ssood123/Project-Emphy/README_HARDWARE.md

# Emphy Overview
The hardware for Emphy consists of three different components:
1. The OpenBot car
2. Raspberry pi
3. Leash. 

## OpenBot Car
The hardware design for our final prototype was taken directly from the [OpenBot GitHub](https://github.com/intel-isl/OpenBot/tree/master). This design includes 4 different 3D printed parts for the chassis as shown below. The cad designs and STL files for 3D printing can be found on the OpenBot Github under [body](https://github.com/intel-isl/OpenBot/tree/master/body). While we stuck with the basic design, it can be edited to include space to place a raspberry pi and its power source within the insides of the chassis as well as a mounting point for the leash. 
The design for OpenBot is shown below. It consists on 3D printed parts and off the shelf hardware and electronics which can all be bought online. The complete list of parts required for this car can be found [here](https://github.com/intel-isl/OpenBot/tree/master/body). 

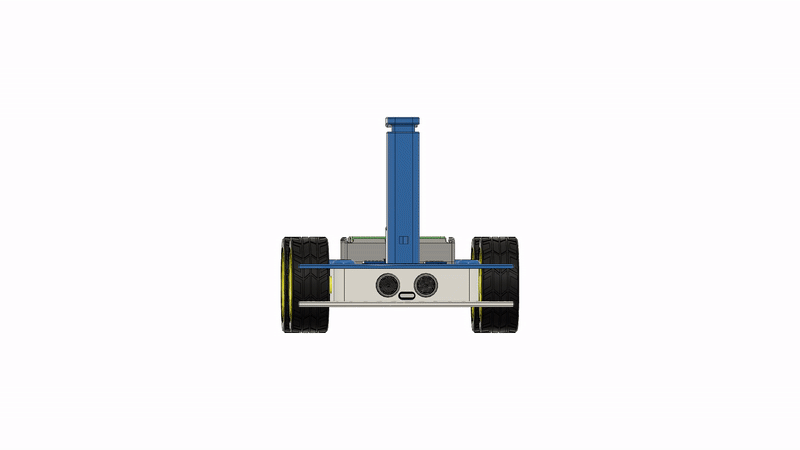
[picture p1: Images/assembly.gif]
Assembly


The wiring and components images for the car below are taken from the OpenBot github.

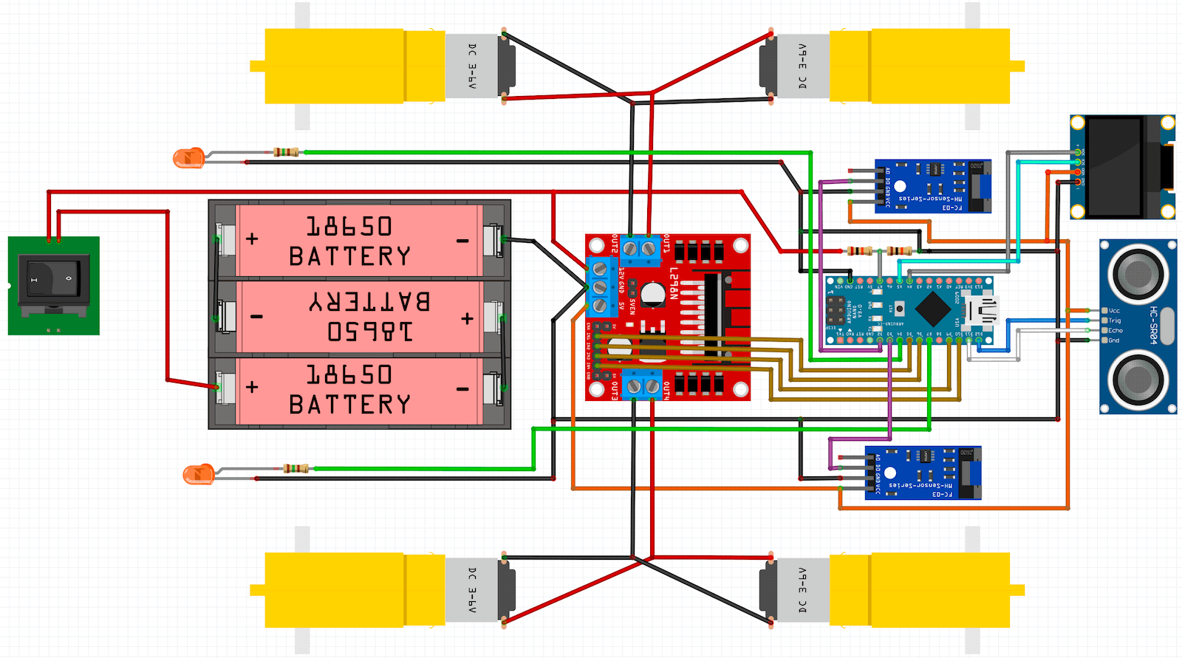
[picture p2: Images/wiring_diagram.png]

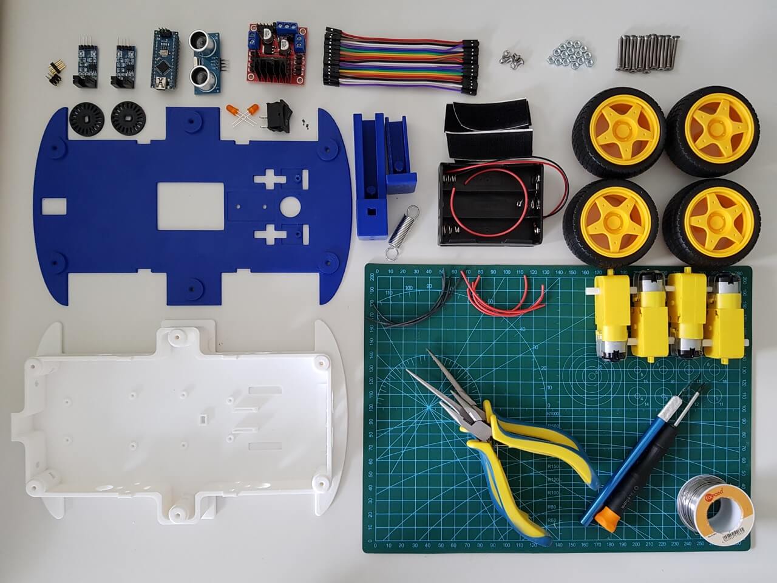
[picture p3: Images/diy_parts.jpg]

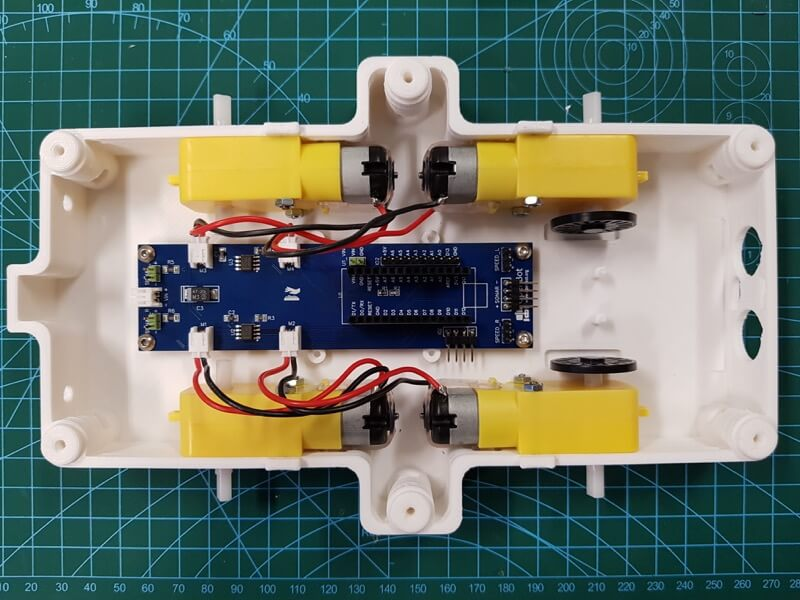
[picture p4: Images/chassis_motors_pcb.jpg]


When assembling this robot ourselves using an arduino nano and not a custom pcb, the complexity of the internal wiring and the assembeled OpenBot is shown below. This still requires the leash and Raspberry pi to be added which are discussed later.

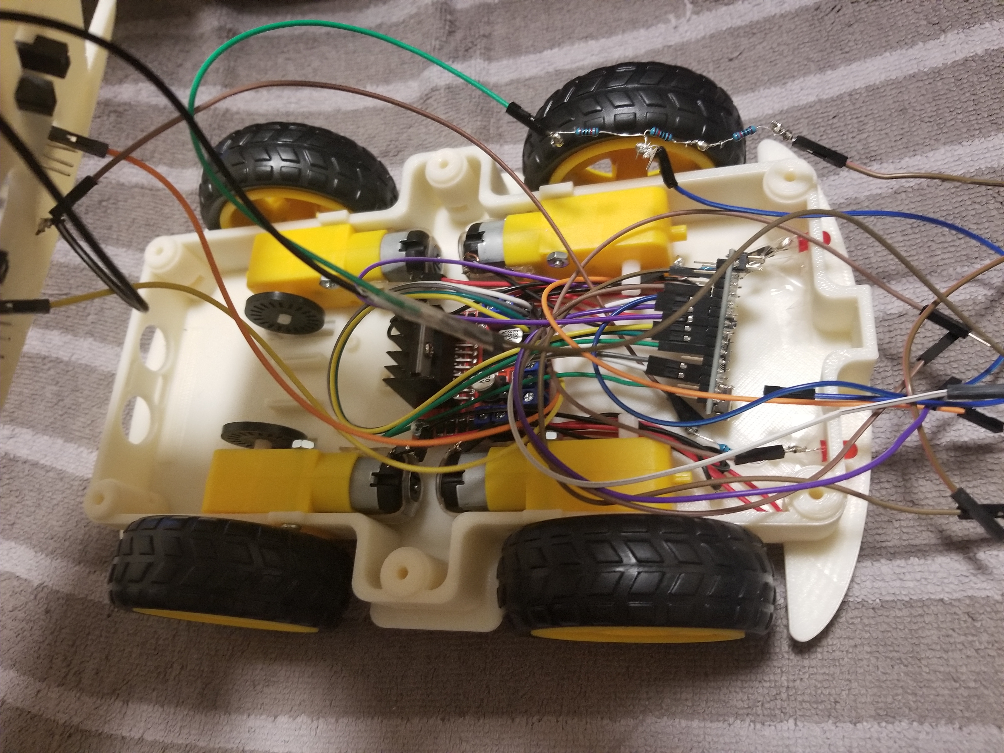
[picture p5: Images/internal_wiring.jpg]

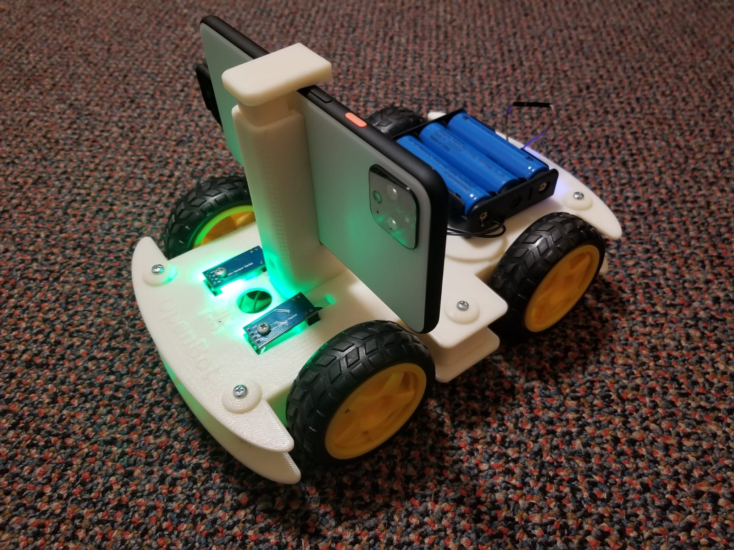
[picture p6: Images/OpenBot.jpeg]



## Raspberry Pi 4B
To control the OpenBot robot, we use a raspberry pi 4B which can communicate with the OpenBot application. There are no special instructions needed for the raspberry pi setup and previous version of raspberry pi with Wifi capabilites should be capable of running the [Emphy.py](https://github.com/BostonUniversitySeniorDesign/21-07-Emphy/blob/main/Emphy-OpenBot/Emphy.py) python script on them. The leash is connected to the raspberry pi through hardware pins and a USB headset which acts as a speaker and mic is connected to the Raspberry pi. The assembly of the leash is described below while the Headset can be any regular [headset](https://www.bestbuy.com/site/insignia-on-ear-analog-mono-headset-black/5648055.p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). The headset needs to be correctly set up which is described in the software readme file and in the future, can possibly be replaced with a bluetooth headset. The raspberry pi is attached to the car body as shown below. Changes to the 3D printed body can allow for the Pi and the battery pack to be stored within the body.

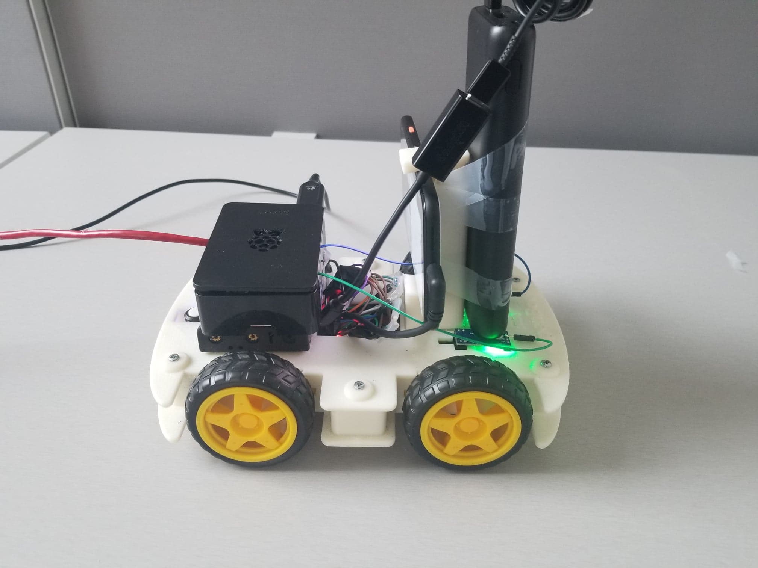
[picture p7: Images/latest1.jpg]

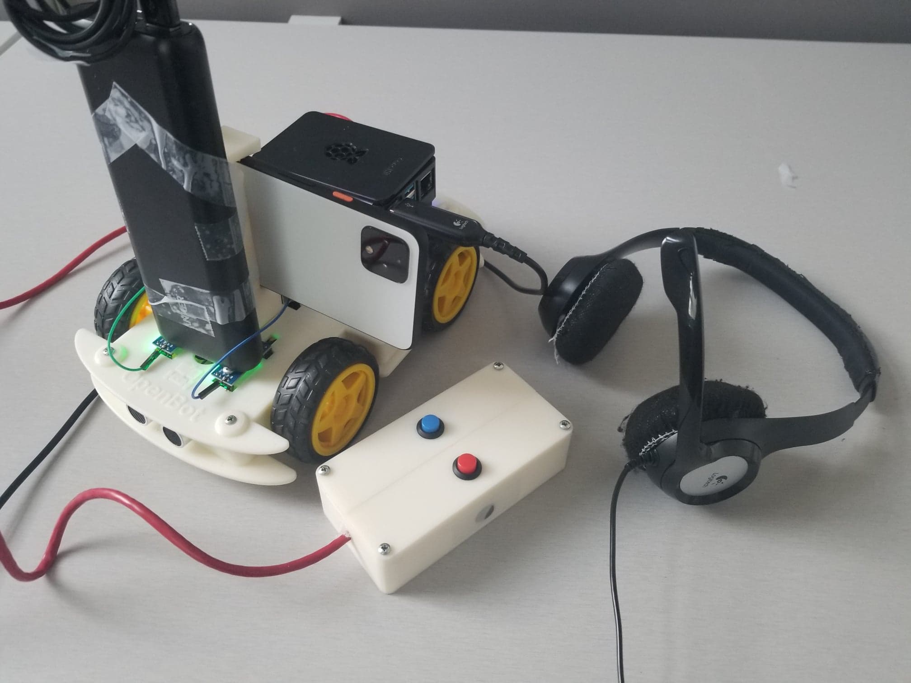
[picture p8: Images/latest2.jpg]

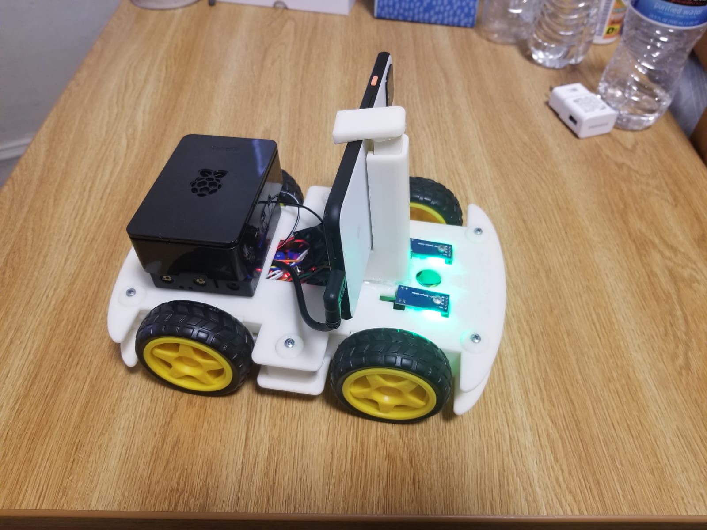
[picture p9: Images/OpenBot3.jpeg]

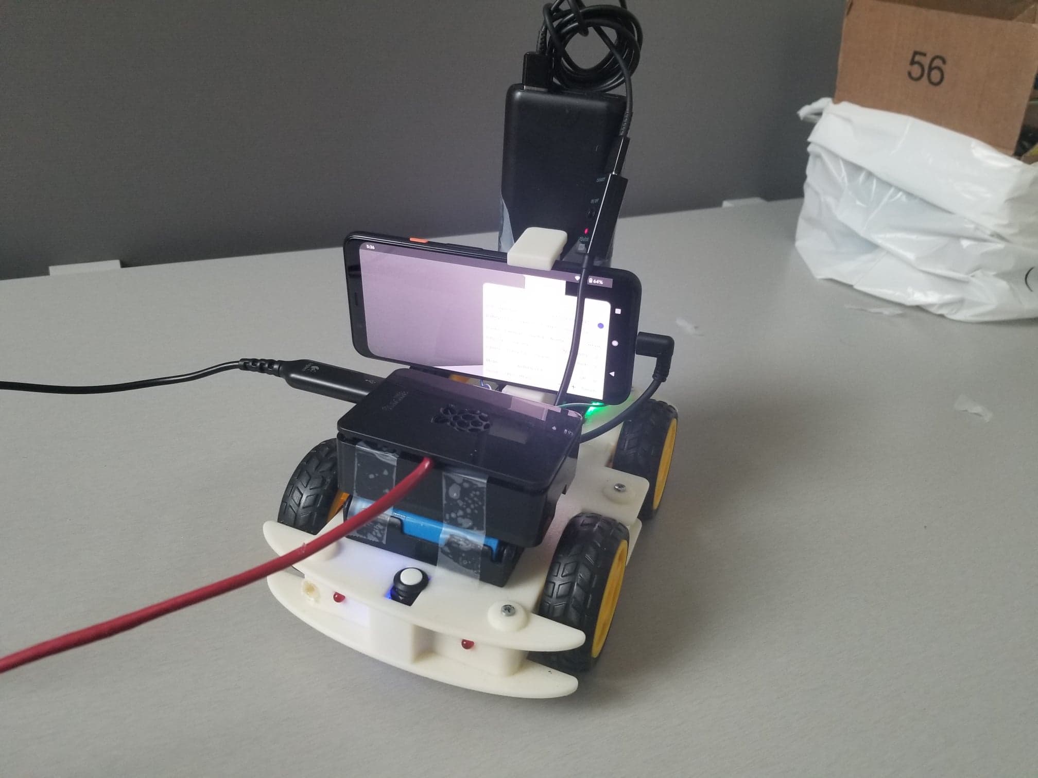
[picture p10: Images/latest4.jpg]


### Leash Box
The purpose of the leash is to establish a way for the user to communicate with Emphy as well as a way for the car to communicate back to the user, through haptic feedback implemented on the leash as well as audio output through the Headset. The leash consists of two vibration motors on the left and right of the leash to indicate where the car will turn. There are also two buttons on the top of the leash, one to pause the robot in its track and the other to stop the robot from continuing on the current path and to ask the user again for a new destination. These components are then connected to the raspberry pi over a long wire which also acts as a leash for the user to hold. The 3D printed box acts as a handle for the user.
The CAD files inside LeashBox folder is for the box attached to the leash. They are in stl format and can be used to 3D printed the box. The box’s dimension is 12x6x3 cm. The lid has two identical parts. On the lid there are two holes for the buttons and four holes on the corner which are placed for the screws to connect the lid and the box body. The box has two holes on the sides for vibration motor and a hole on the front for the wire to go through.
The CAD is done using onShape.

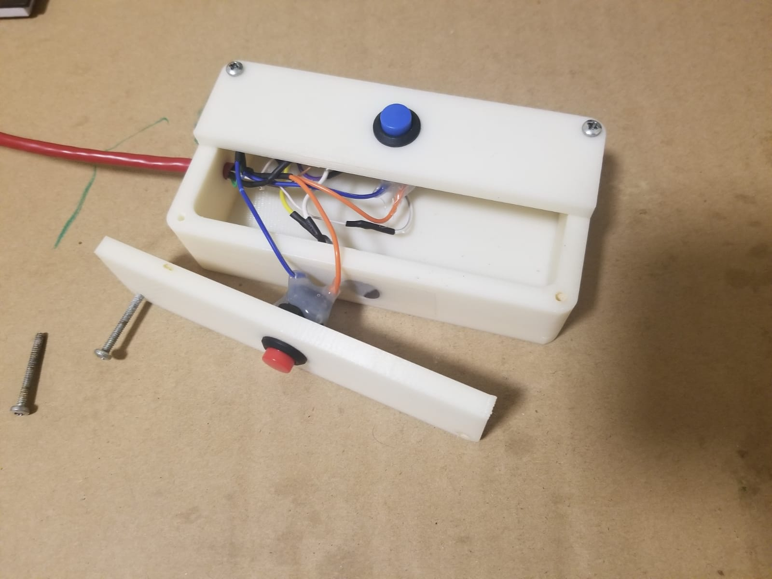
[picture p11: Images/leash.jpeg]

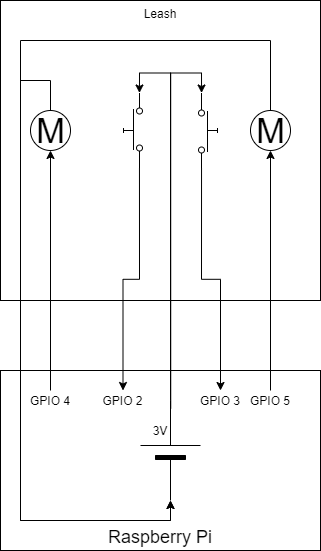
[picture p12: Images/Leash_diagram.png]
