ssood123/Project-Emphy/Emphy-OpenBot/OpenBot-master/docs/images/add_disk_motor.jpg

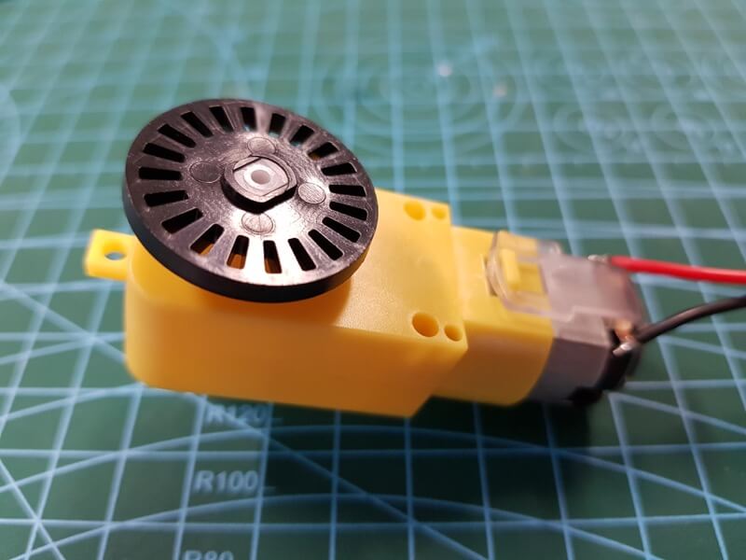
Emphy-OpenBot/OpenBot-master/docs/images/add_disk_motor.jpg
