ssood123/Project-Emphy/Emphy-OpenBot/OpenBot-master/docs/images/add_wires_motor.jpg

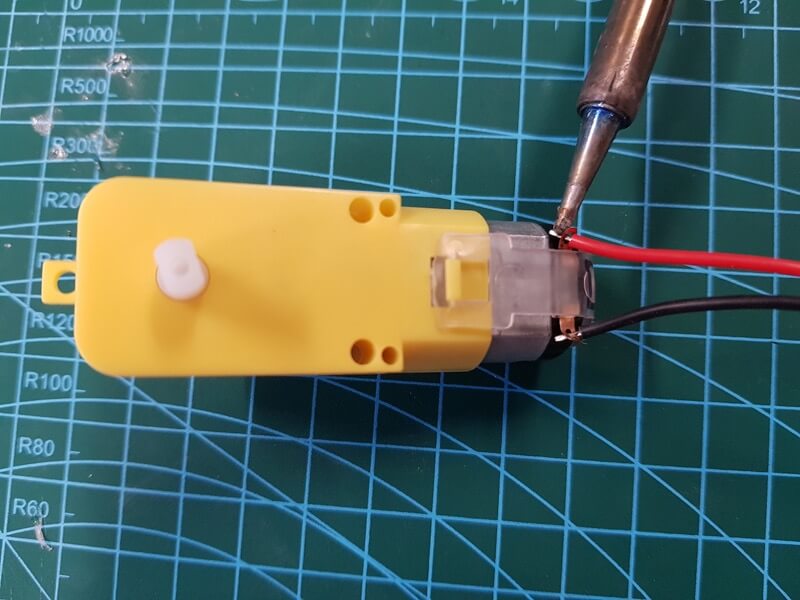
Emphy-OpenBot/OpenBot-master/docs/images/add_wires_motor.jpg
