ssood123/Project-Emphy/Emphy-OpenBot/OpenBot-master/docs/images/ai_screen.jpg

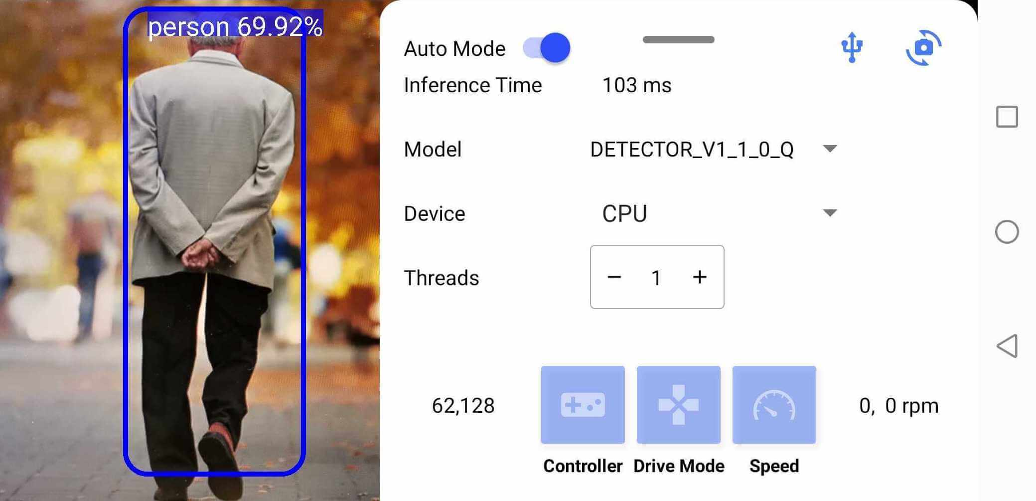
Emphy-OpenBot/OpenBot-master/docs/images/ai_screen.jpg
