ssood123/Project-Emphy/Emphy-OpenBot/OpenBot-master/docs/images/android_studio_sdk.jpg

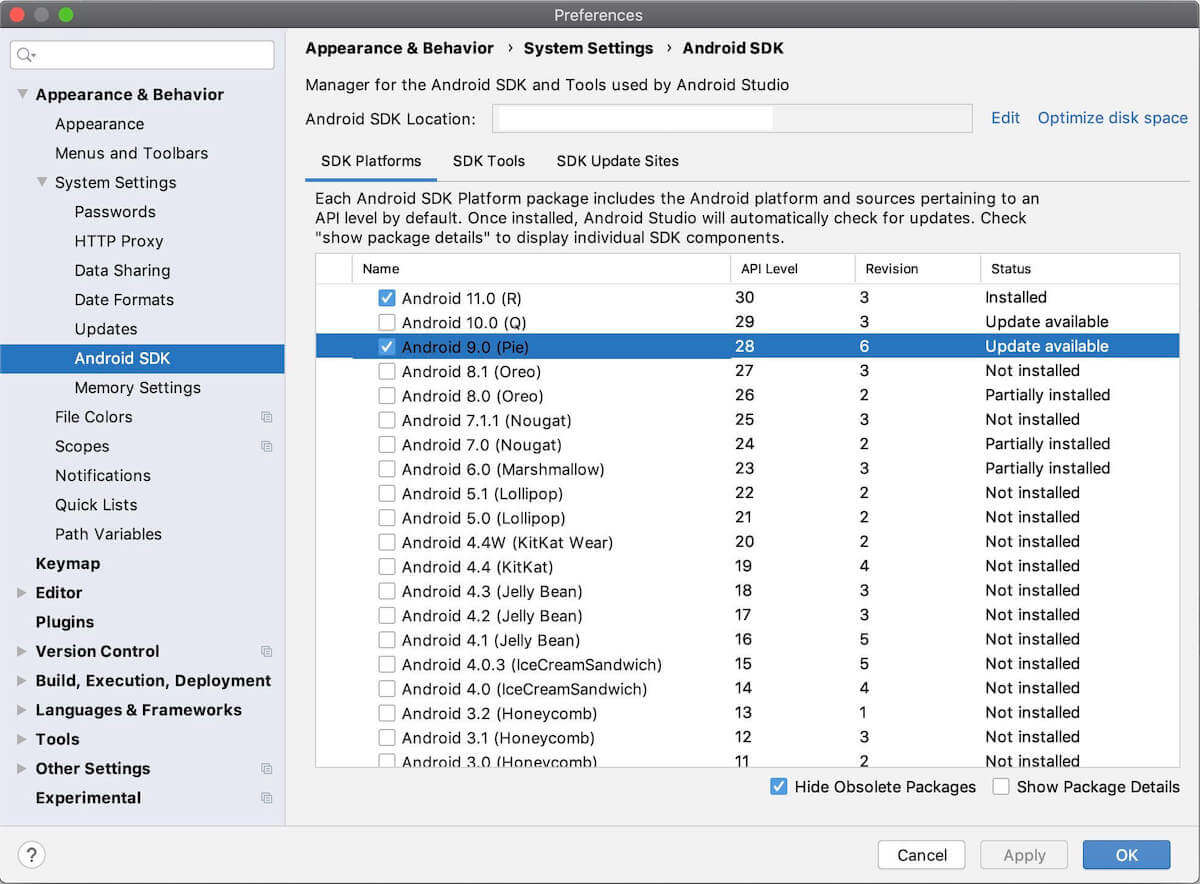
Emphy-OpenBot/OpenBot-master/docs/images/android_studio_sdk.jpg
