ssood123/Project-Emphy/Emphy-OpenBot/OpenBot-master/docs/images/android_studio_tflite_dir.jpg

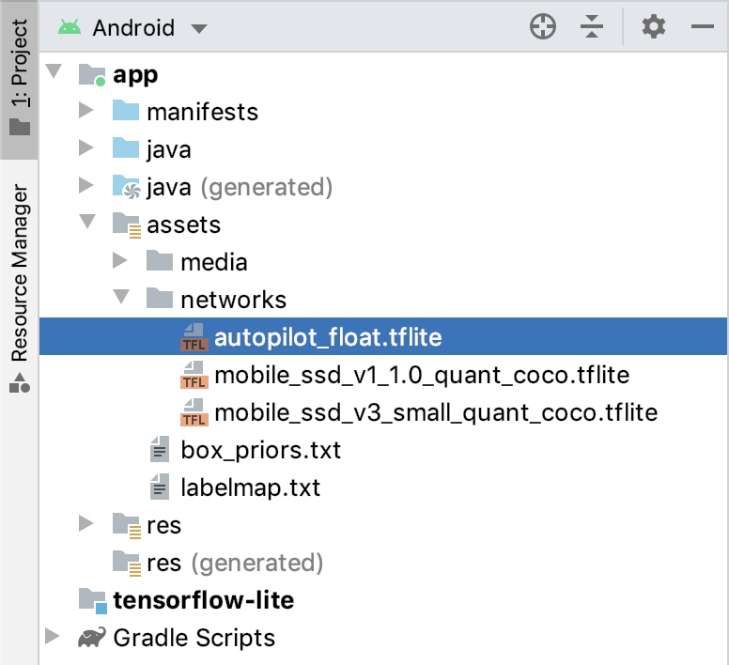
Emphy-OpenBot/OpenBot-master/docs/images/android_studio_tflite_dir.jpg
