ssood123/Project-Emphy/Emphy-OpenBot/OpenBot-master/docs/images/app_controller_settings_1.png

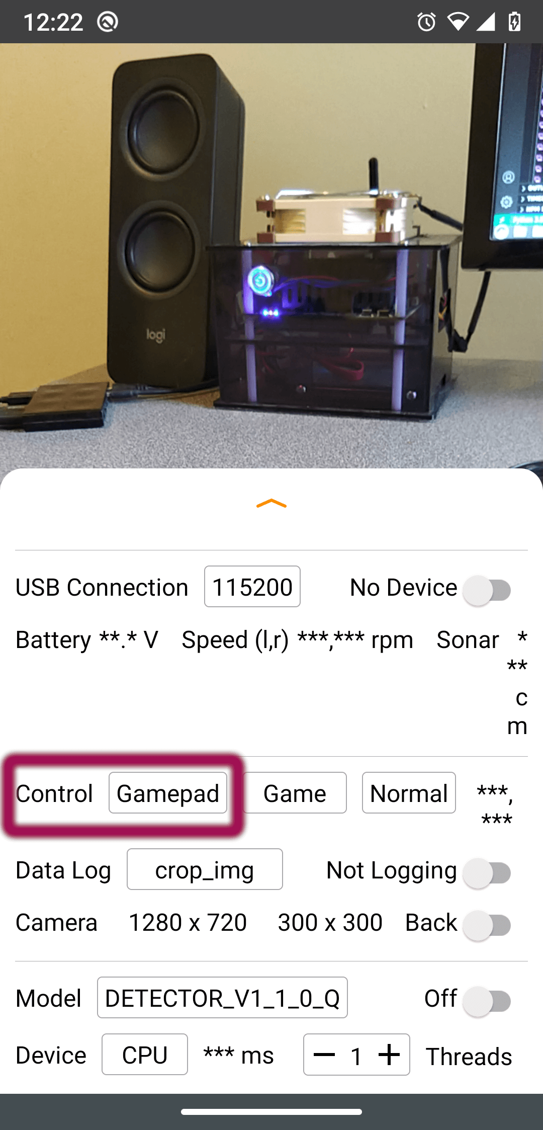
Emphy-OpenBot/OpenBot-master/docs/images/app_controller_settings_1.png
