ssood123/Project-Emphy/Emphy-OpenBot/OpenBot-master/docs/images/app_gui_1.jpg

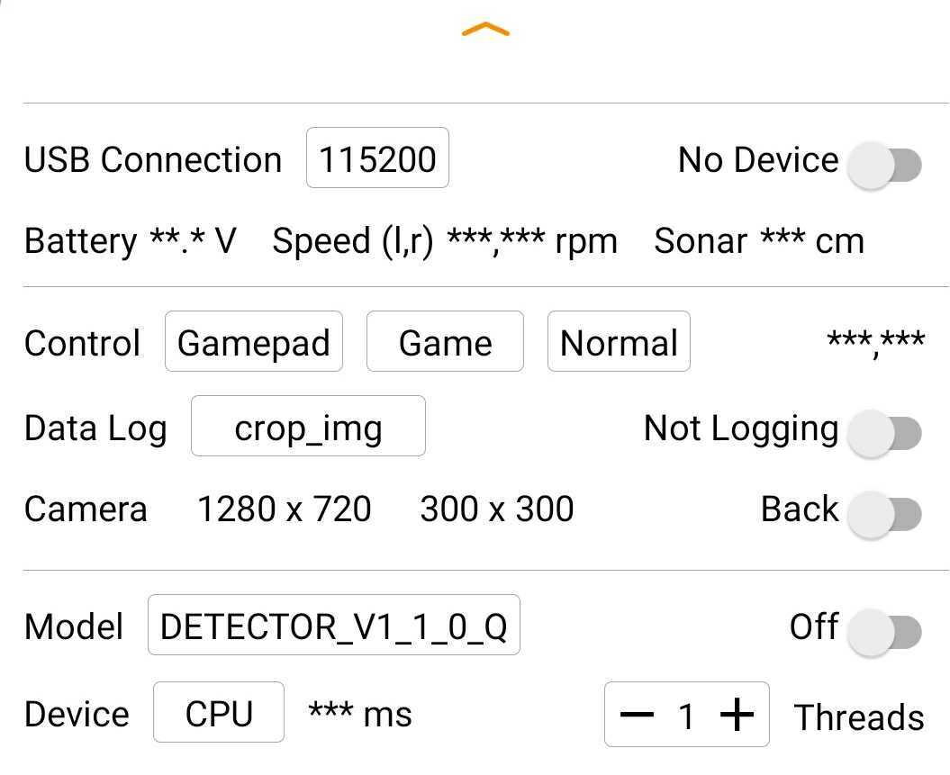
Emphy-OpenBot/OpenBot-master/docs/images/app_gui_1.jpg
