ssood123/Project-Emphy/Emphy-OpenBot/OpenBot-master/docs/images/app_gui_2.jpg

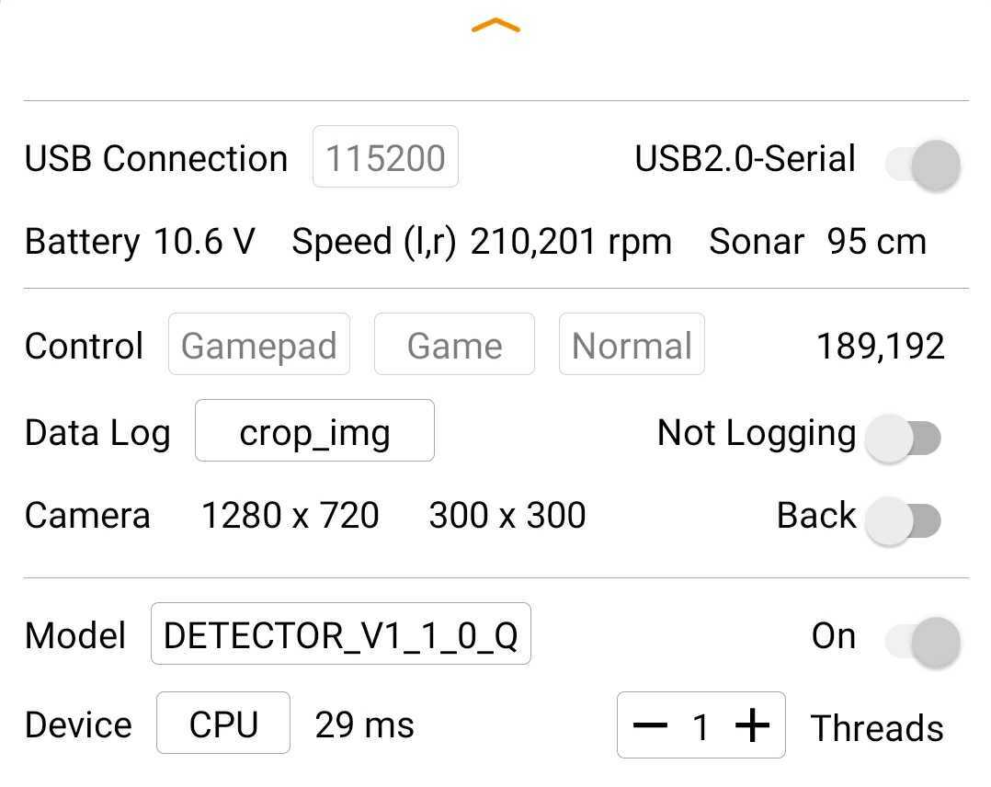
Emphy-OpenBot/OpenBot-master/docs/images/app_gui_2.jpg
