ssood123/Project-Emphy/Emphy-OpenBot/OpenBot-master/docs/images/app_teaser.jpg

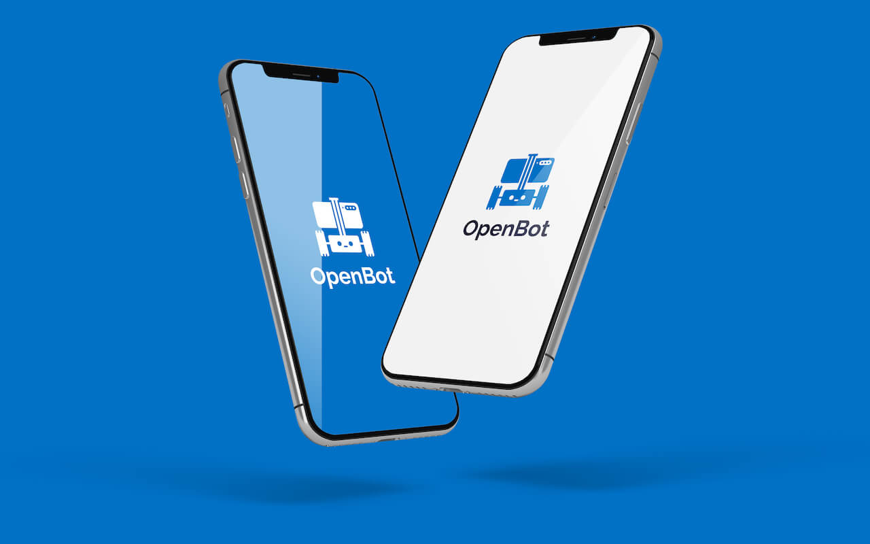
Emphy-OpenBot/OpenBot-master/docs/images/app_teaser.jpg
