ssood123/Project-Emphy/Emphy-OpenBot/OpenBot-master/docs/images/attach_motors_2.jpg

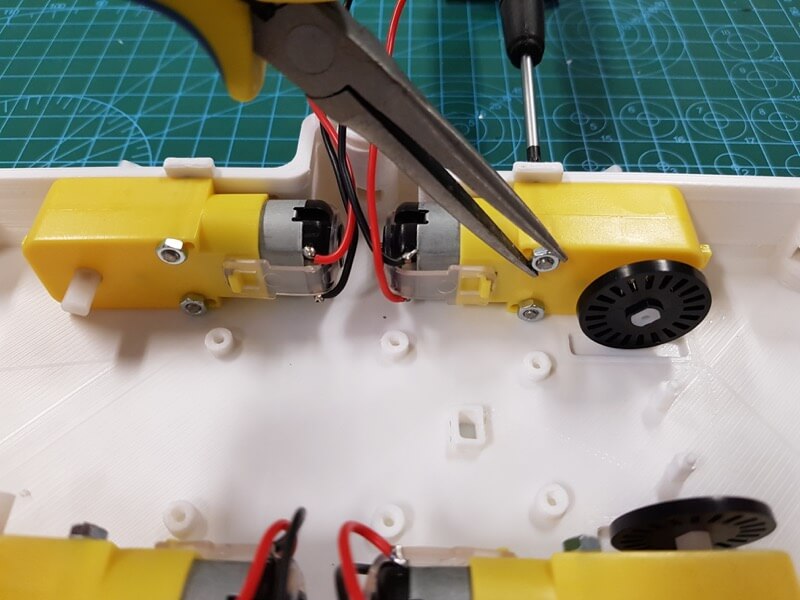
Emphy-OpenBot/OpenBot-master/docs/images/attach_motors_2.jpg
