ssood123/Project-Emphy/Emphy-OpenBot/OpenBot-master/docs/images/attach_motors_3.jpg

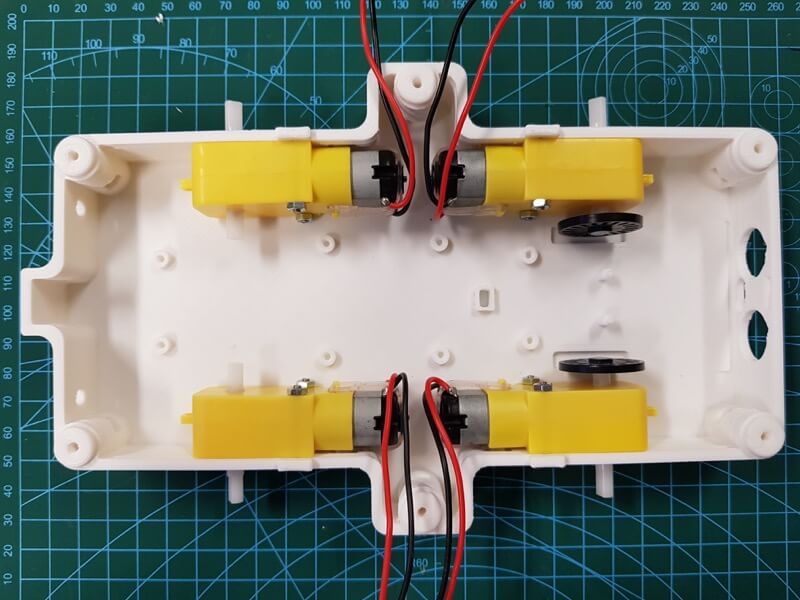
Emphy-OpenBot/OpenBot-master/docs/images/attach_motors_3.jpg
