ssood123/Project-Emphy/Emphy-OpenBot/OpenBot-master/docs/images/attach_pcb.jpg

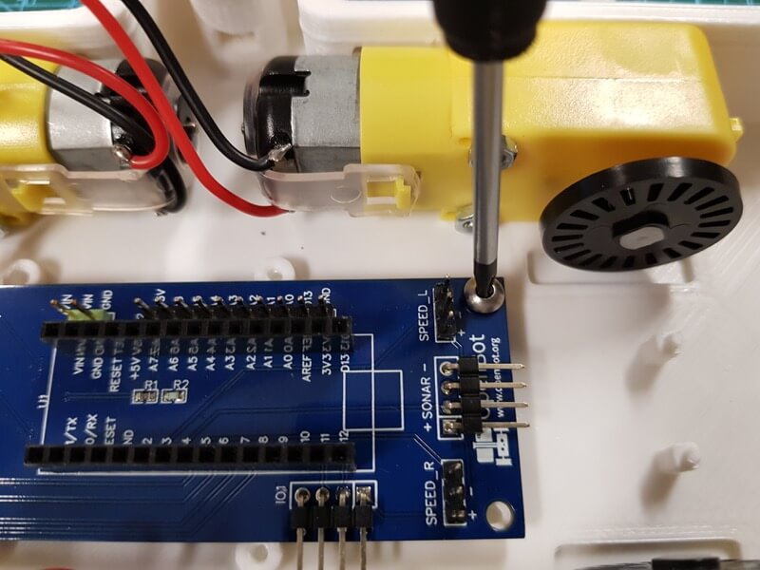
Emphy-OpenBot/OpenBot-master/docs/images/attach_pcb.jpg
