ssood123/Project-Emphy/Emphy-OpenBot/OpenBot-master/docs/images/chassis_cardboard_1.jpg

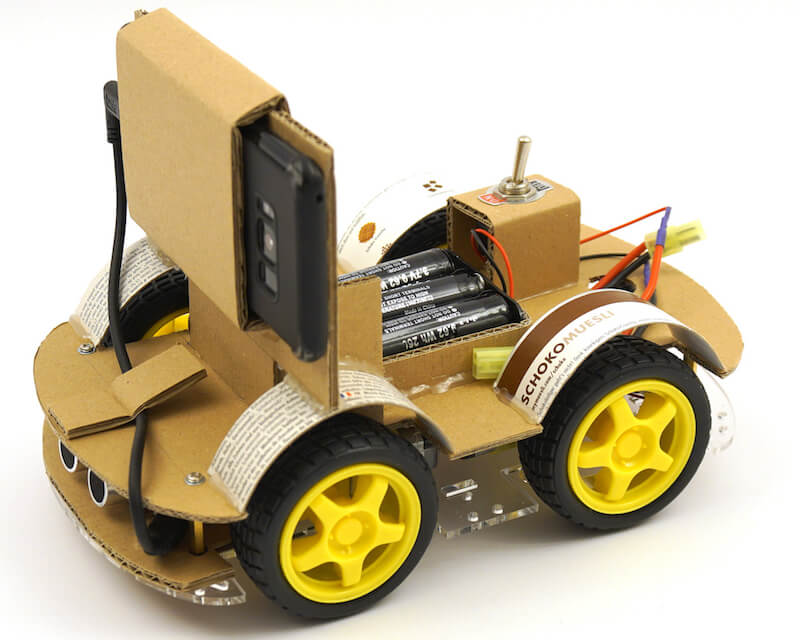
Emphy-OpenBot/OpenBot-master/docs/images/chassis_cardboard_1.jpg
