ssood123/Project-Emphy/Emphy-OpenBot/OpenBot-master/docs/images/chassis_cardboard_2.jpg

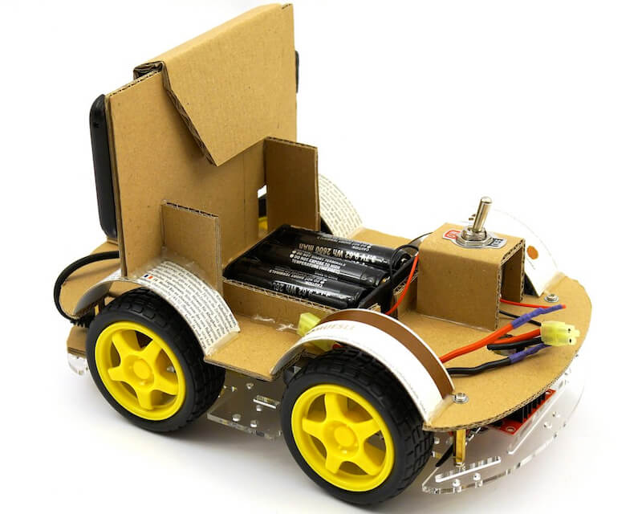
Emphy-OpenBot/OpenBot-master/docs/images/chassis_cardboard_2.jpg
