ssood123/Project-Emphy/Emphy-OpenBot/OpenBot-master/docs/images/connect_motors_pcb.jpg

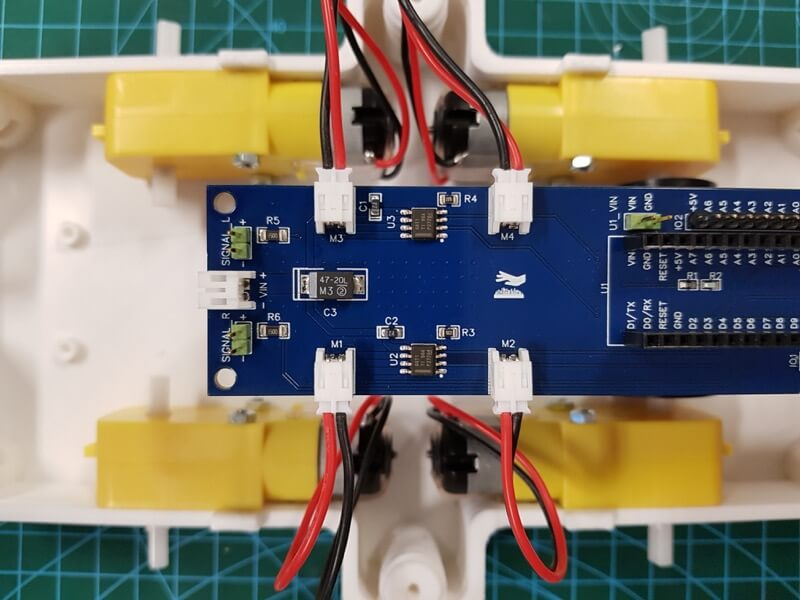
Emphy-OpenBot/OpenBot-master/docs/images/connect_motors_pcb.jpg
