ssood123/Project-Emphy/Emphy-OpenBot/OpenBot-master/docs/images/connect_sonar_sensor.jpg

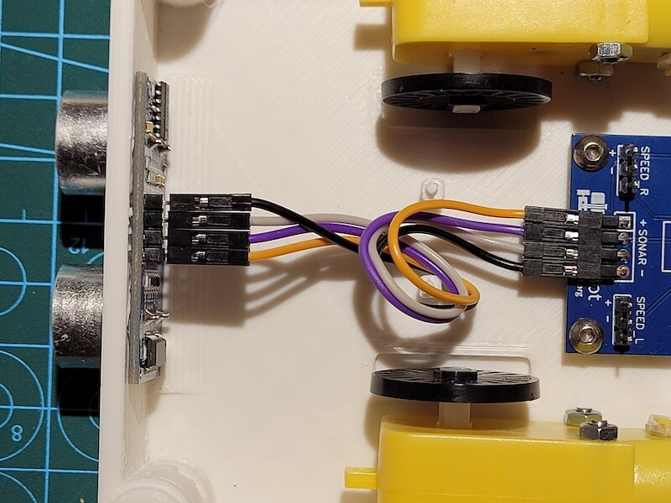
Emphy-OpenBot/OpenBot-master/docs/images/connect_sonar_sensor.jpg
