ssood123/Project-Emphy/Emphy-OpenBot/OpenBot-master/docs/images/controller_command_buttons.png

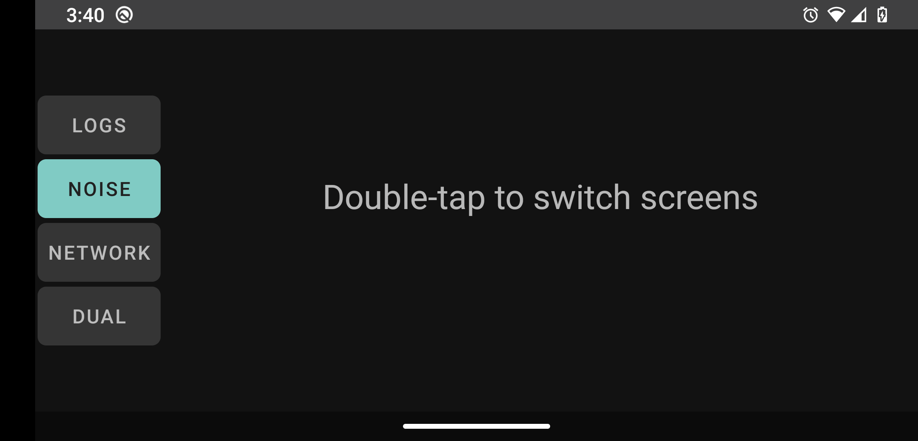
Emphy-OpenBot/OpenBot-master/docs/images/controller_command_buttons.png
