ssood123/Project-Emphy/Emphy-OpenBot/OpenBot-master/docs/images/controller_pre_connect.png

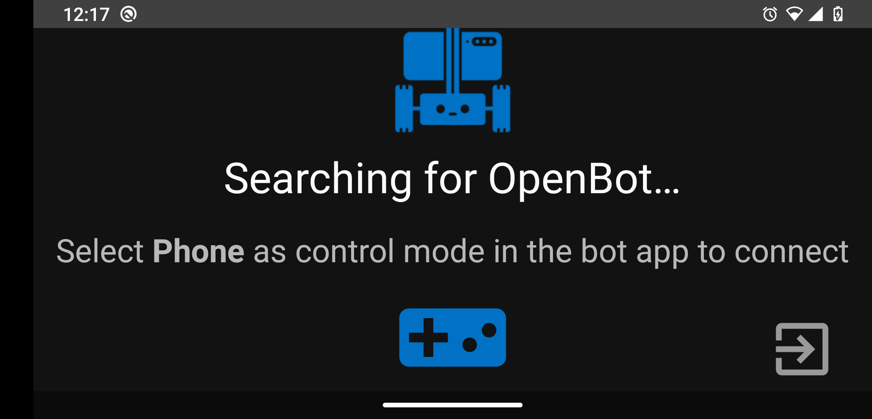
Emphy-OpenBot/OpenBot-master/docs/images/controller_pre_connect.png
