ssood123/Project-Emphy/Emphy-OpenBot/OpenBot-master/docs/images/folder_structure.png

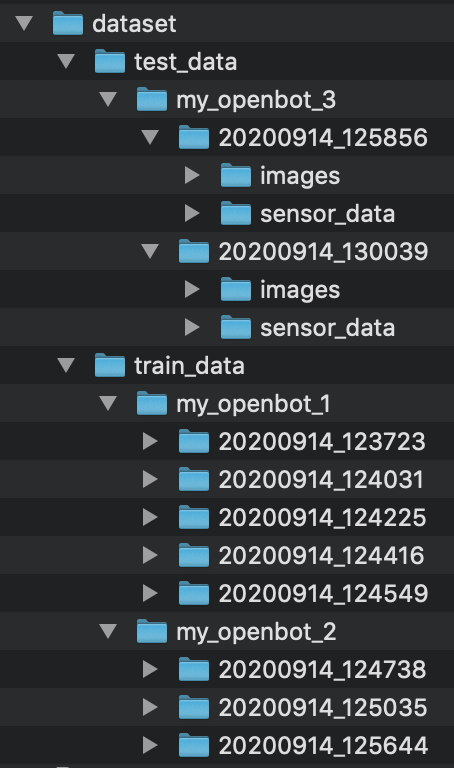
Emphy-OpenBot/OpenBot-master/docs/images/folder_structure.png
