ssood123/Project-Emphy/Emphy-OpenBot/OpenBot-master/docs/images/game_screen.jpg

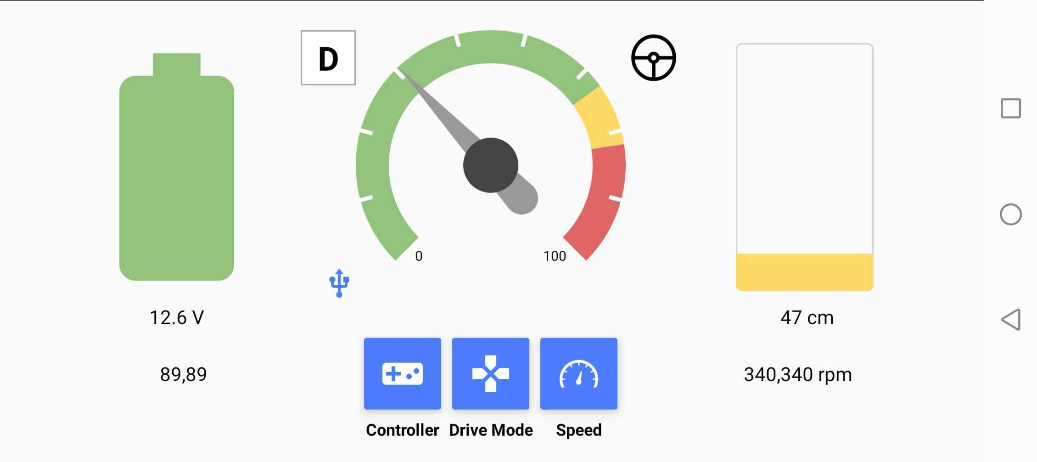
Emphy-OpenBot/OpenBot-master/docs/images/game_screen.jpg
