ssood123/Project-Emphy/Emphy-OpenBot/OpenBot-master/docs/images/glue_body.jpg

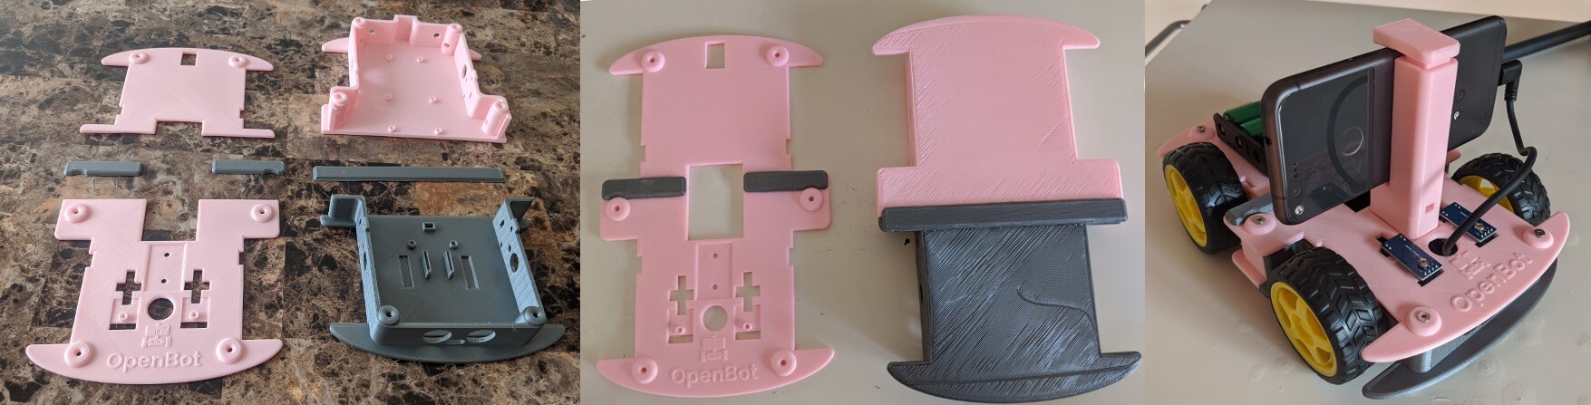
Emphy-OpenBot/OpenBot-master/docs/images/glue_body.jpg
