ssood123/Project-Emphy/Emphy-OpenBot/OpenBot-master/docs/images/led_insert.jpg

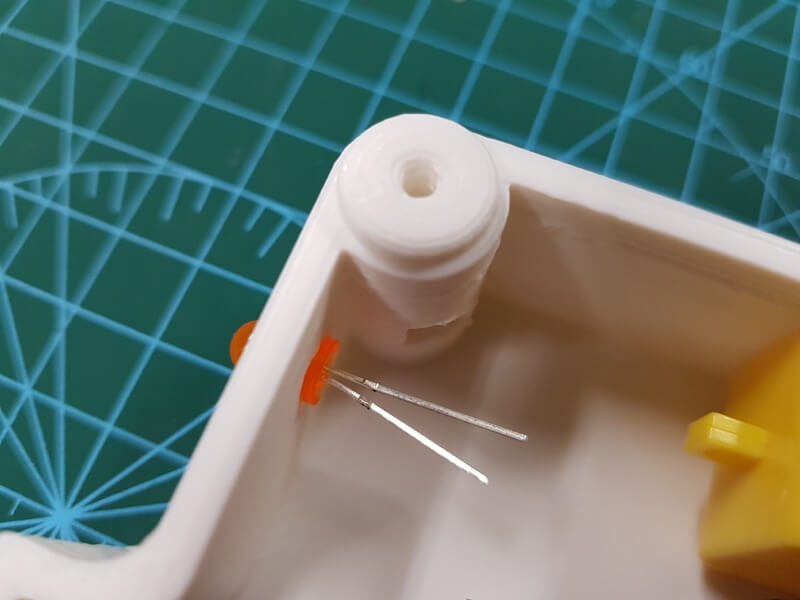
Emphy-OpenBot/OpenBot-master/docs/images/led_insert.jpg
