ssood123/Project-Emphy/Emphy-OpenBot/OpenBot-master/docs/images/led_left.jpg

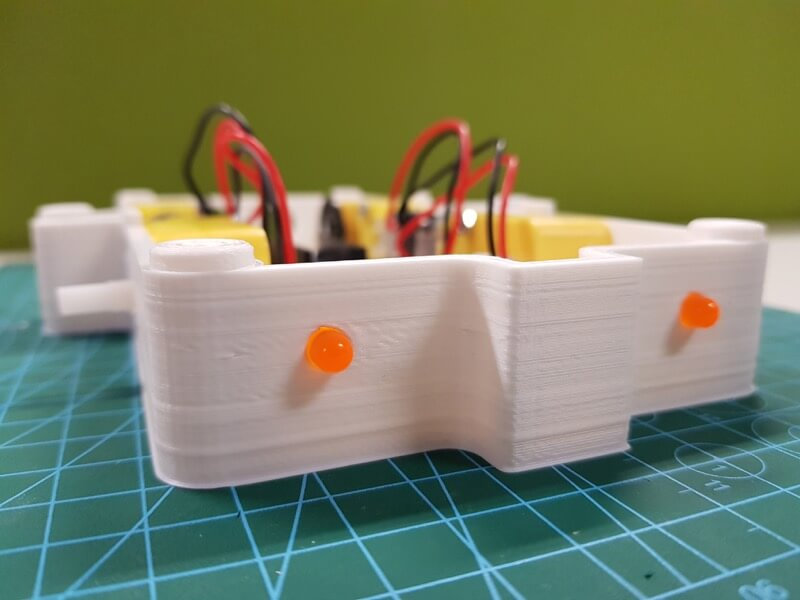
Emphy-OpenBot/OpenBot-master/docs/images/led_left.jpg
