ssood123/Project-Emphy/Emphy-OpenBot/OpenBot-master/docs/images/led_right.jpg

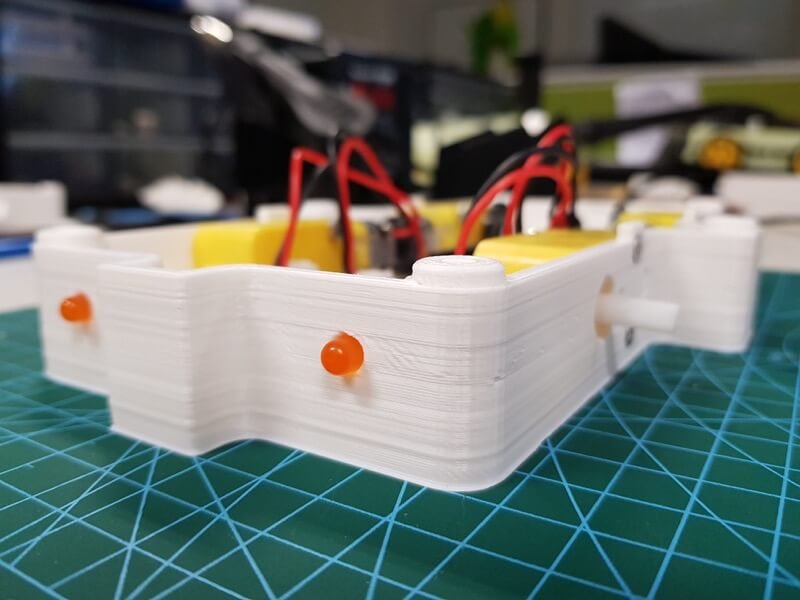
Emphy-OpenBot/OpenBot-master/docs/images/led_right.jpg
