ssood123/Project-Emphy/Emphy-OpenBot/OpenBot-master/docs/images/logger_screen.jpg

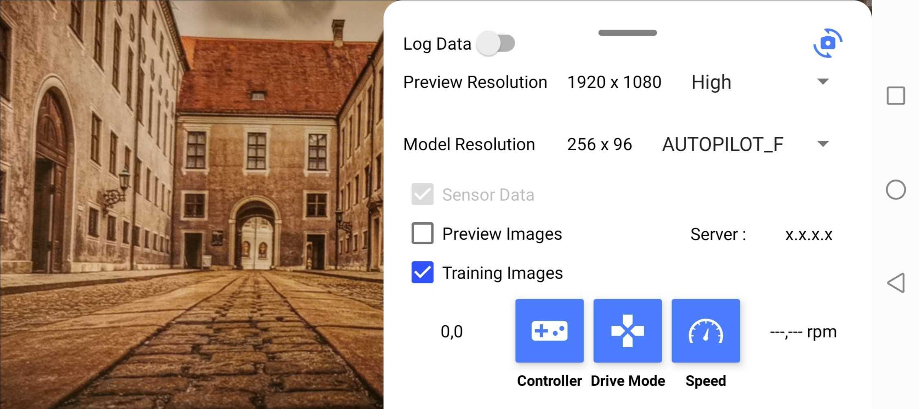
Emphy-OpenBot/OpenBot-master/docs/images/logger_screen.jpg
