ssood123/Project-Emphy/Emphy-OpenBot/OpenBot-master/docs/images/manage_libraries.jpg

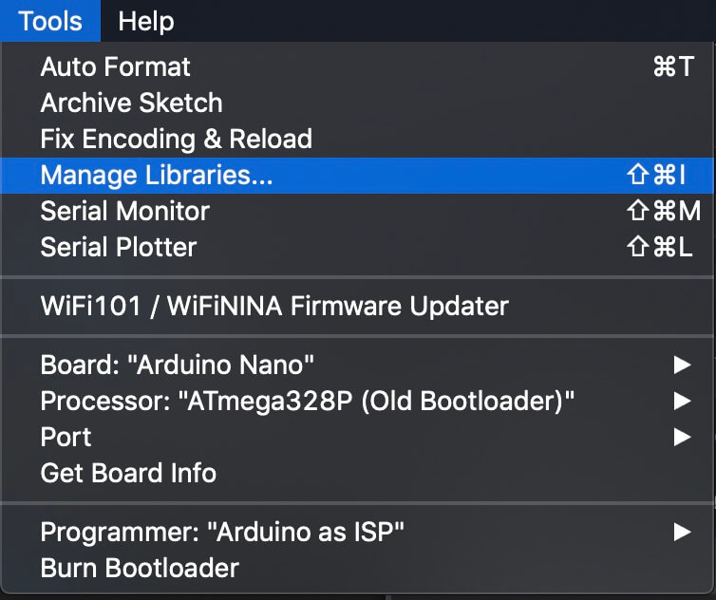
Emphy-OpenBot/OpenBot-master/docs/images/manage_libraries.jpg
