ssood123/Project-Emphy/Emphy-OpenBot/OpenBot-master/docs/images/menu_selector.jpg

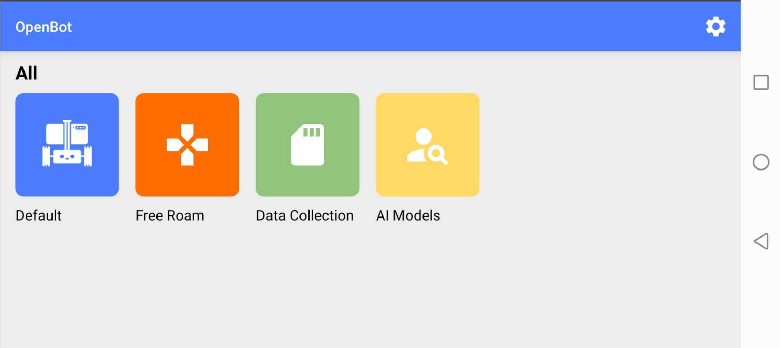
Emphy-OpenBot/OpenBot-master/docs/images/menu_selector.jpg
