ssood123/Project-Emphy/Emphy-OpenBot/OpenBot-master/docs/images/openbot_2wd.jpg

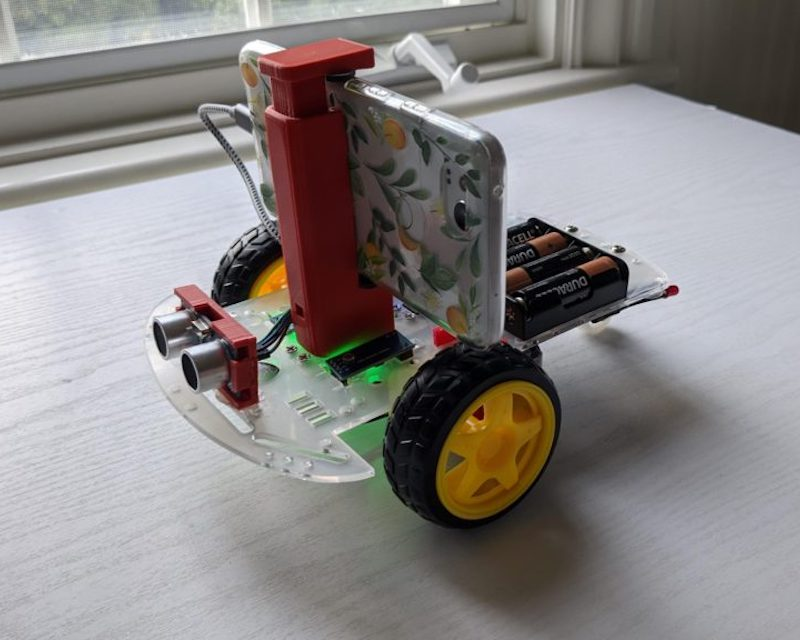
Emphy-OpenBot/OpenBot-master/docs/images/openbot_2wd.jpg
