ssood123/Project-Emphy/Emphy-OpenBot/OpenBot-master/docs/images/openbot_tank.jpg

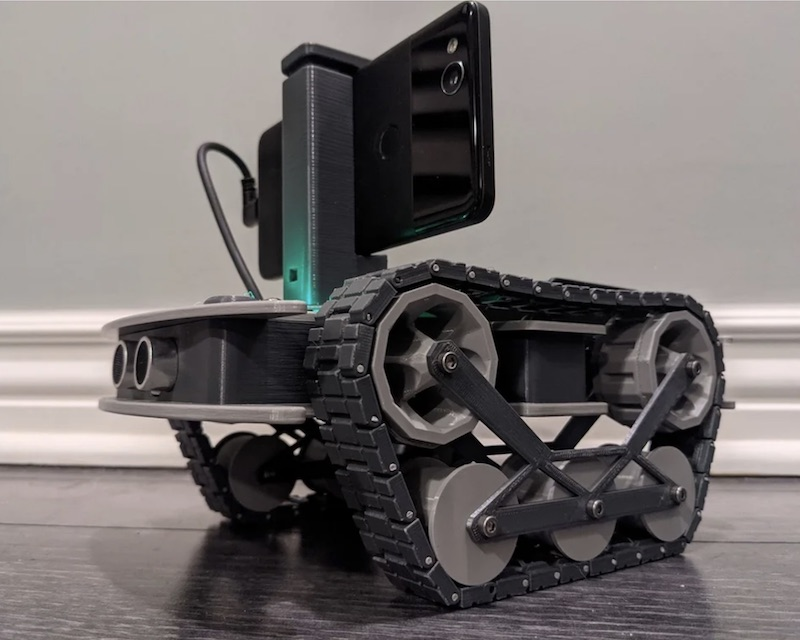
Emphy-OpenBot/OpenBot-master/docs/images/openbot_tank.jpg
