ssood123/Project-Emphy/Emphy-OpenBot/OpenBot-master/docs/images/openbot_yoda.jpg

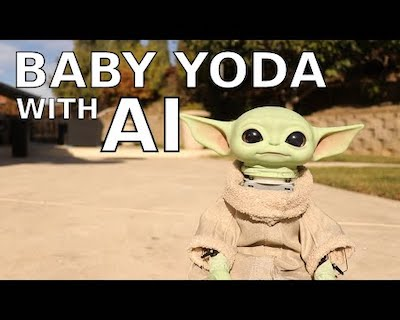
Emphy-OpenBot/OpenBot-master/docs/images/openbot_yoda.jpg
