ssood123/Project-Emphy/Emphy-OpenBot/OpenBot-master/docs/images/pcb_2d_v2.png

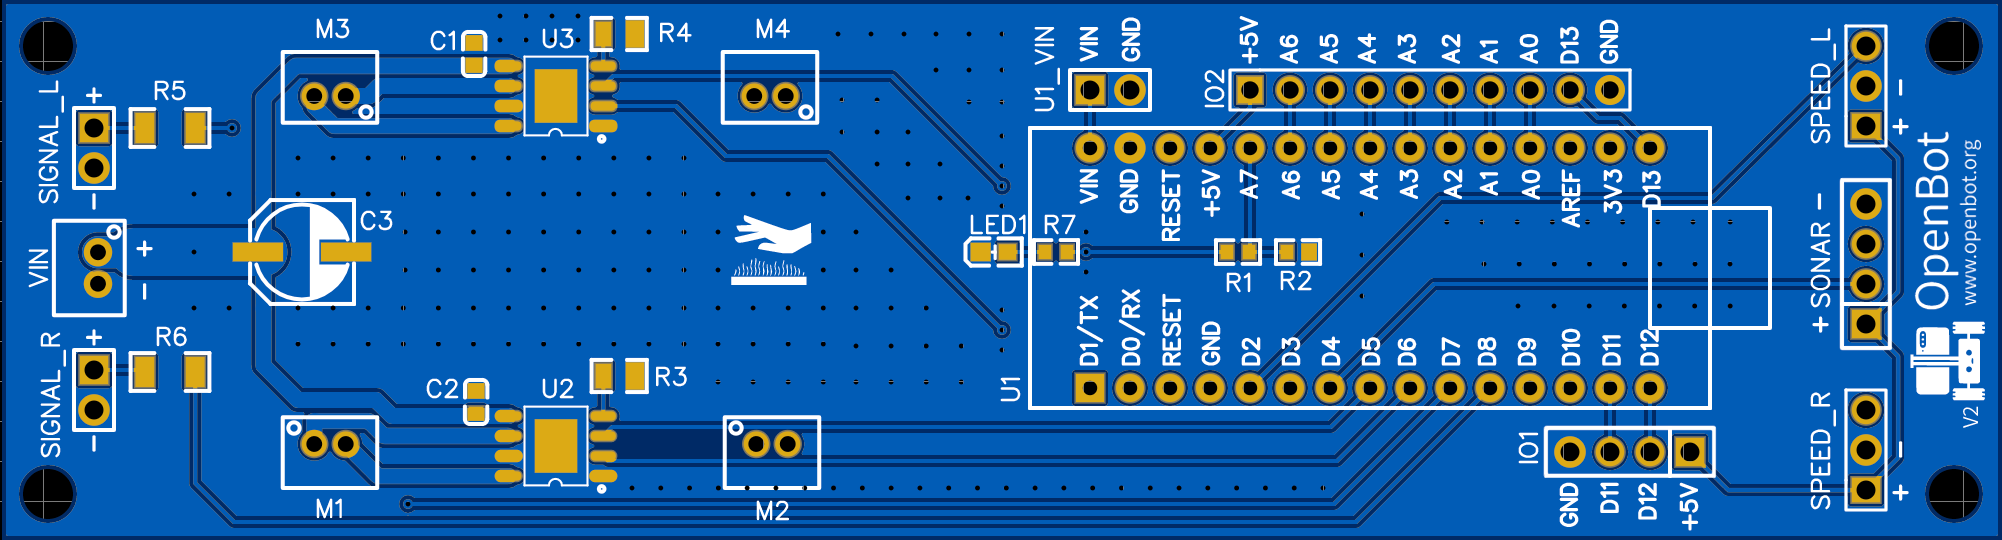
Emphy-OpenBot/OpenBot-master/docs/images/pcb_2d_v2.png
