ssood123/Project-Emphy/Emphy-OpenBot/OpenBot-master/docs/images/pcb_3d_v1.png

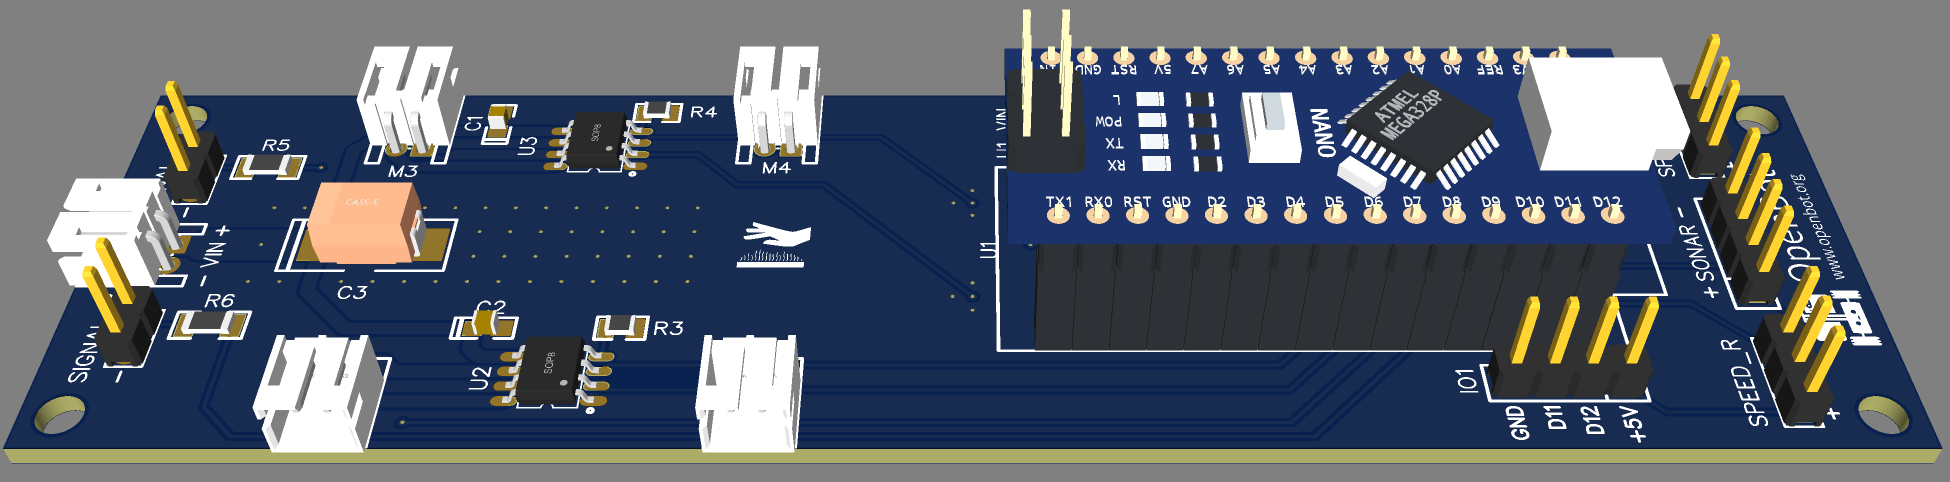
Emphy-OpenBot/OpenBot-master/docs/images/pcb_3d_v1.png
