ssood123/Project-Emphy/Emphy-OpenBot/OpenBot-master/docs/images/serial_monitor.png

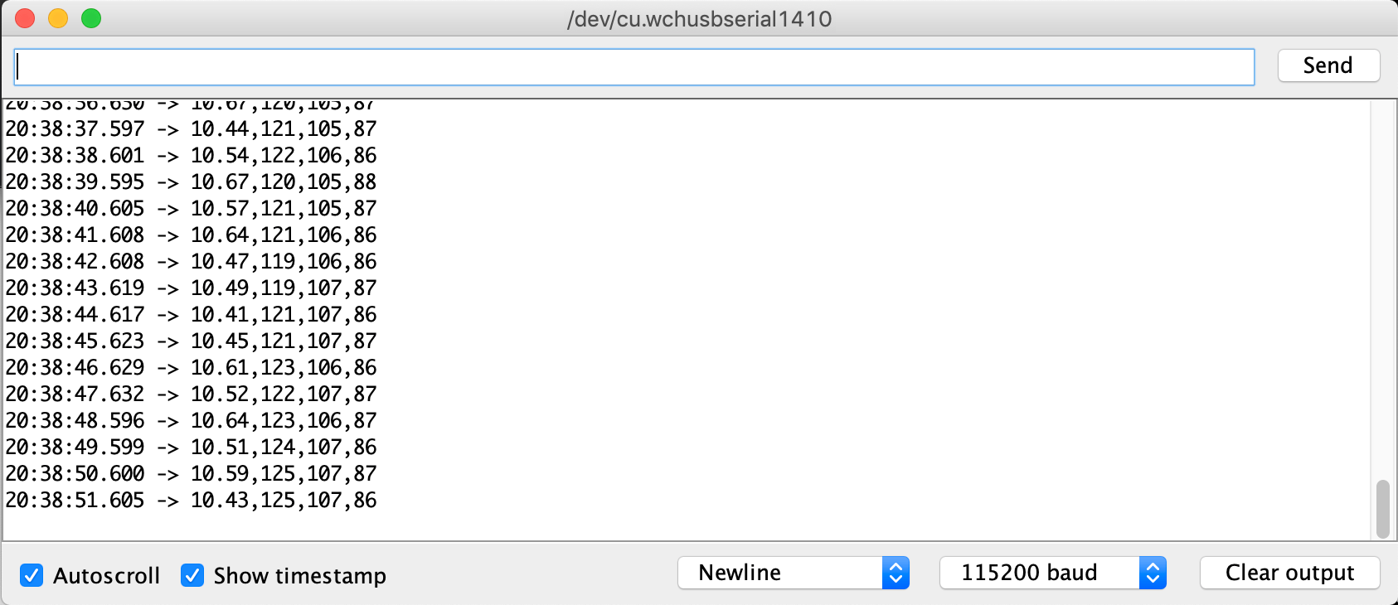
Emphy-OpenBot/OpenBot-master/docs/images/serial_monitor.png
