ssood123/Project-Emphy/Emphy-OpenBot/OpenBot-master/docs/images/slim_body.jpg

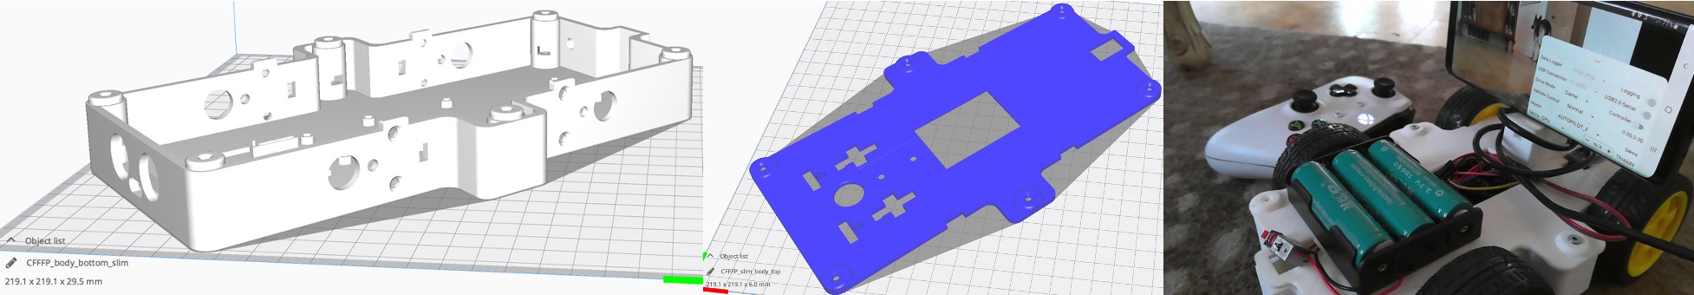
Emphy-OpenBot/OpenBot-master/docs/images/slim_body.jpg
