ssood123/Project-Emphy/Emphy-OpenBot/OpenBot-master/docs/images/sonar_back.jpg

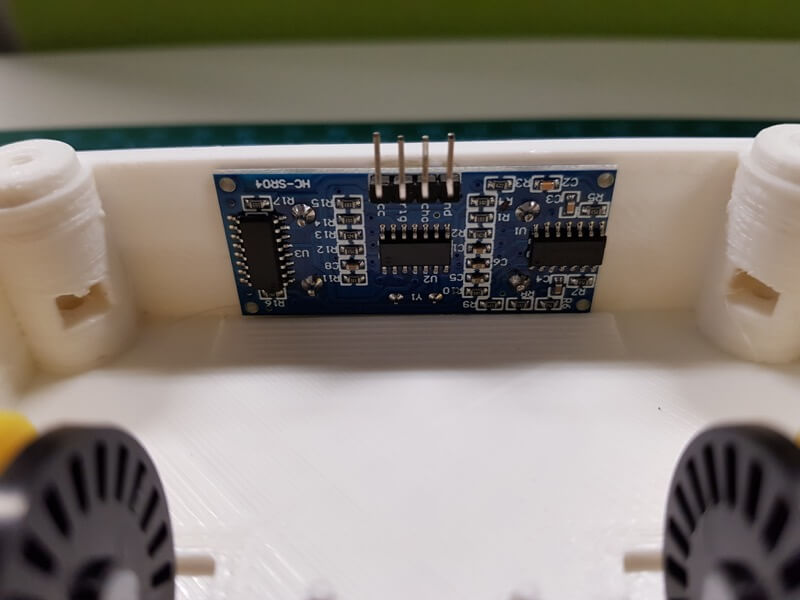
Emphy-OpenBot/OpenBot-master/docs/images/sonar_back.jpg
