ssood123/Project-Emphy/Emphy-OpenBot/OpenBot-master/docs/images/sonar_bend_pins.jpg

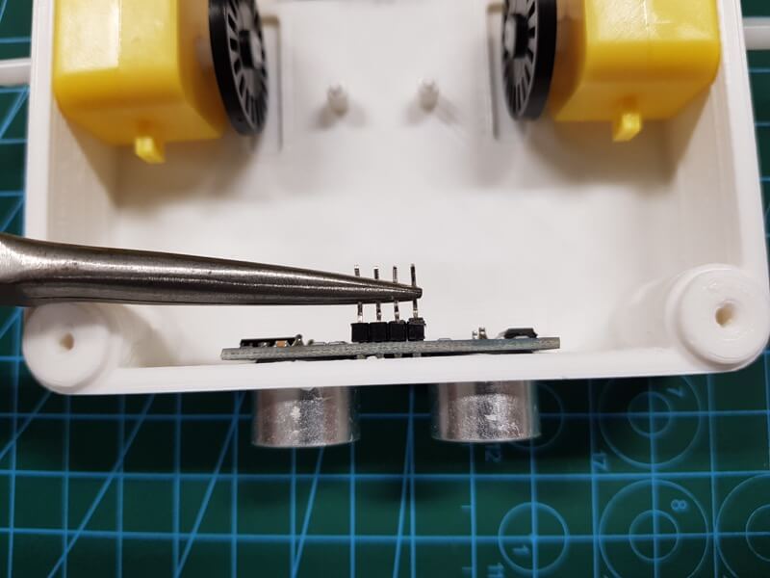
Emphy-OpenBot/OpenBot-master/docs/images/sonar_bend_pins.jpg
