ssood123/Project-Emphy/Emphy-OpenBot/OpenBot-master/docs/images/sonar_front.jpg

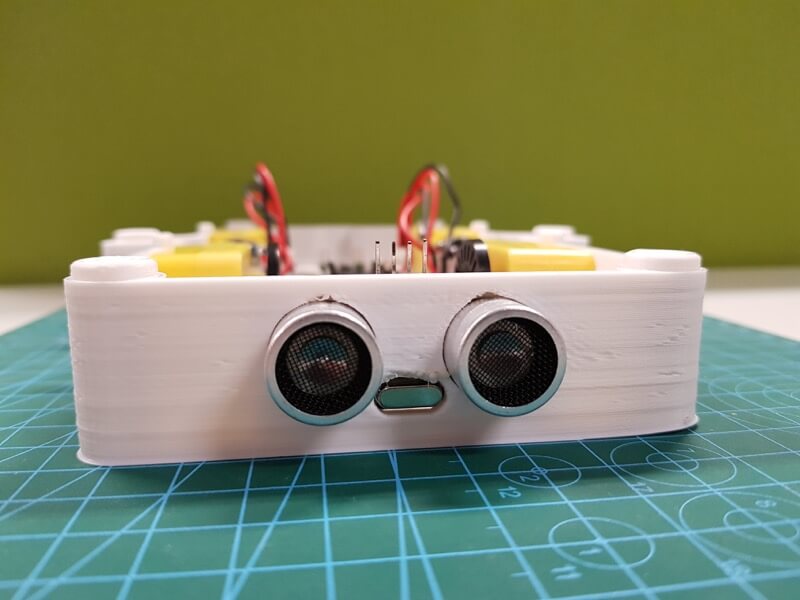
Emphy-OpenBot/OpenBot-master/docs/images/sonar_front.jpg
