ssood123/Project-Emphy/Emphy-OpenBot/OpenBot-master/docs/images/youtube.jpg

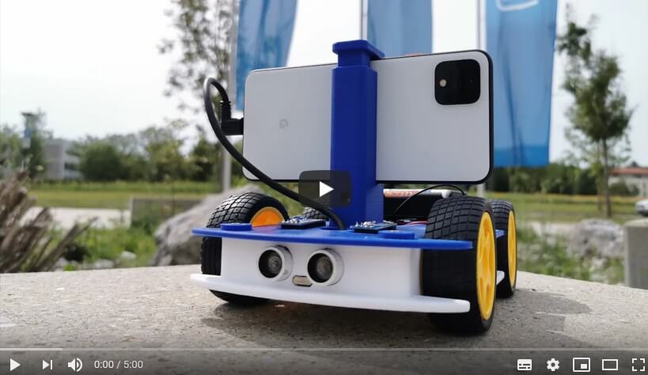
Emphy-OpenBot/OpenBot-master/docs/images/youtube.jpg
