ssood123/Project-Emphy/Images/ArduinoBot Flowchart.png

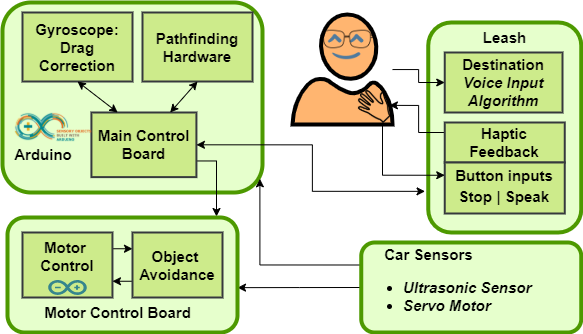
Images/ArduinoBot Flowchart.png
