ssood123/Project-Emphy/Images/latest3.jpg

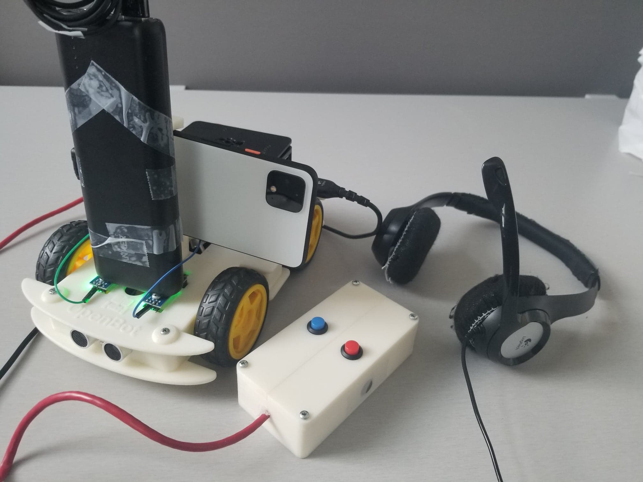
Images/latest3.jpg
