ssood123/Project-Emphy/Images/OpenBot Flowchart.png

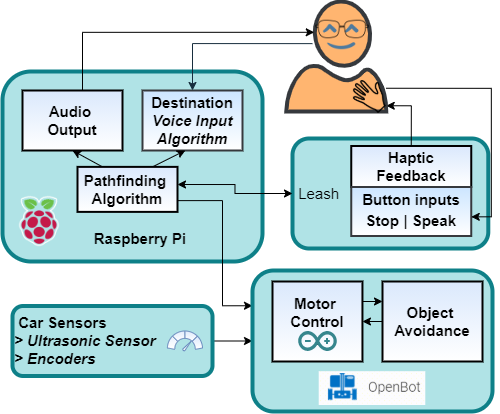
Images/OpenBot Flowchart.png
