ssood123/Project-Emphy/Images/PhotonicsSecondFloor.jpg

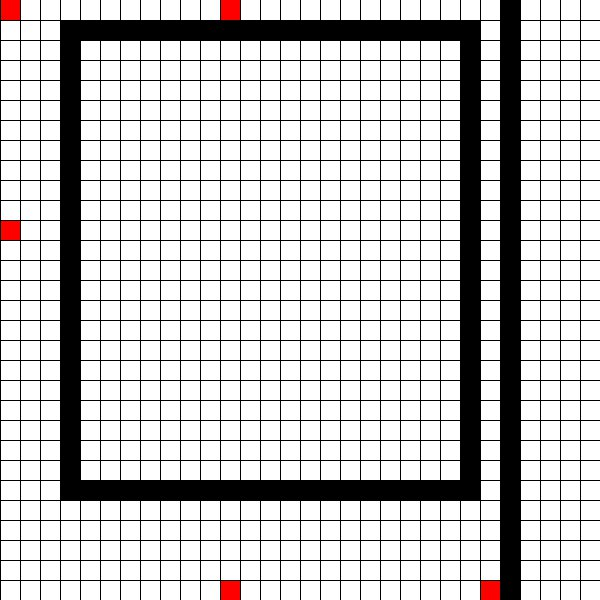
Images/PhotonicsSecondFloor.jpg
