ssood123/Project-Emphy/Emphy-OpenBot/OpenBot-master/body/pcb/v2/BOM_v2.csv

ID | Name | Designator | Footprint | Quantity | Manufacturer Part | Manufacturer | Supplier | Supplier Part | LCSC Assembly
1 | B2B-PH-K-S(LF)(SN) | M2,VIN,M4,M3,M1 | CONN-TH_B2B-PH-K-S | 5 | B2B-PH-K-S(LF)(SN) | JST Sales America | LCSC | C131337
2 | Header-Male-2.54_1x4 | IO1 | DIP-1X4P-2.54MM-M | 1 | C124378 | Ckmtw(Shenzhen Cankemeng) | LCSC | C124378
3 | Header-Male-2.54_1x4 | SONAR | DIP-1X4P-2.54MM-M | 1 | C91552 | BOOMELE(Boom Precision Elec) | LCSC | C91552
4 | 16K | R3,R4 | R0805 | 2 | 0805W8F1602T5E | UNI-ROYAL(Uniroyal Elec) | LCSC | C17490
5 | Header-Male-2.54_1x3 | SPEED_L,SPEED_R | HDR-TH_3P-P2.54-V | 2 | Header2.54mm 1*3P | BOOMELE | LCSC | C49257
6 | Header-Male-2.54_1x10 | IO2 | HDR-TH_10P-P2.54-V | 1 | Headers Pins2.54mm1*10P | BOOMELE(Boom Precision Elec) | LCSC | C57369
7 | 1K | R7 | R0603 | 1 | 0603WAJ0102T5E | UniOhm | LCSC | C25585
8 | ARDUINO_NANO | U1 | ARDUINO_NANO | 2 | C124408 | Ckmtw(Shenzhen Cankemeng) | LCSC | C124408
9 | DRV8871DDAR | U3,U2 | SO-8_L4.9-W3.9-P1.27-LS6.0-BL-EP | 2 | DRV8871DDAR | TI | LCSC | C75864 | Yes
10 | 19-217/R6C-AL1M2VY/3T | LED1 | LED0603-R-RD | 1 | 19-217/R6C-AL1M2VY/3T | EVERLIGHT | LCSC | C72044 | Yes
11 | 100nF | C2,C1 | C0603 | 2 | CC0603KRX7R9BB104 | YAGEO | LCSC | C14663 | Yes
12 | 100uF | C3 | CAP-SMD_BD6.3-L6.6-W6.6-RD | 1 | VEJ101M1VTR-0607 | LELON | LCSC | C176666 | Yes
13 | 150 | R6,R5 | R1206 | 2 | 1206W4F1500T5E | UNI-ROYAL(Uniroyal Elec) | LCSC | C17917
14 | 10K | R2 | R0603 | 1 | ARG03BTC1002 | Viking Tech | LCSC | C309083
15 | Header-Male-2.54_1x2 | U1_VIN,SIGNAL_L,SIGNAL_R | HDR-TH_2P-P2.54-V | 3 | C124375 | Ckmtw(Shenzhen Cankemeng) | LCSC | C124375
16 | 20K | R1 | R0603 | 1 | AR03BTCX2002 | Viking Tech | LCSC | C319766
