ssood123/Project-Emphy/Emphy-OpenBot/OpenBot-master/body/cad/glue_body/glue_connector_top_A.step

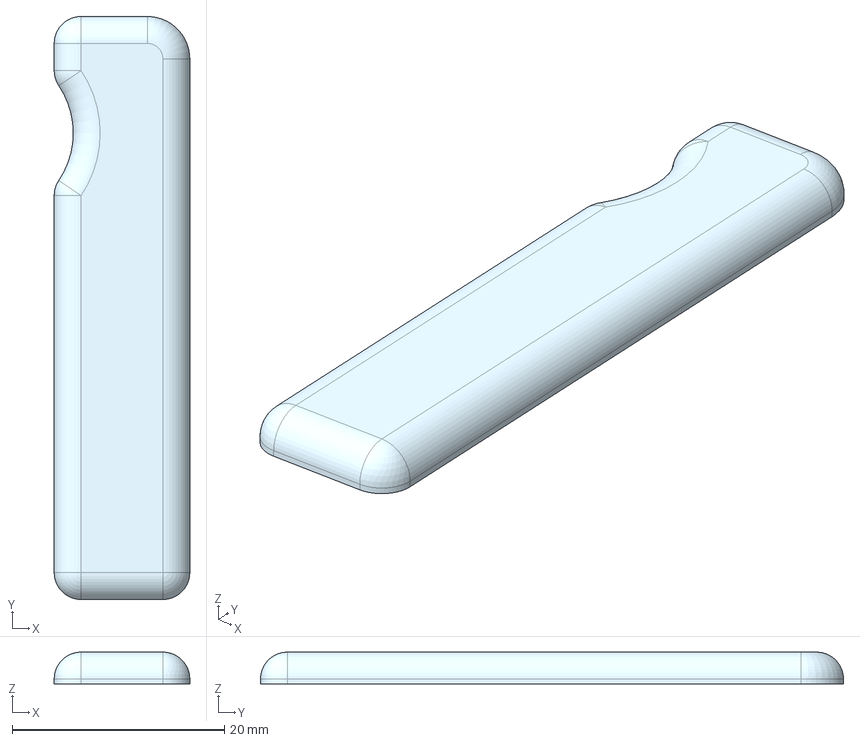
[picture p64: CAD file, 2021-07-04]
Emphy-OpenBot/OpenBot-master/body/cad/glue_body/glue_connector_top_A.step
12.8 x 55.0 x 3.00 mm
