ssood123/Project-Emphy/Emphy-OpenBot/OpenBot-master/body/cad/phone_mount/phone_mount_top.step

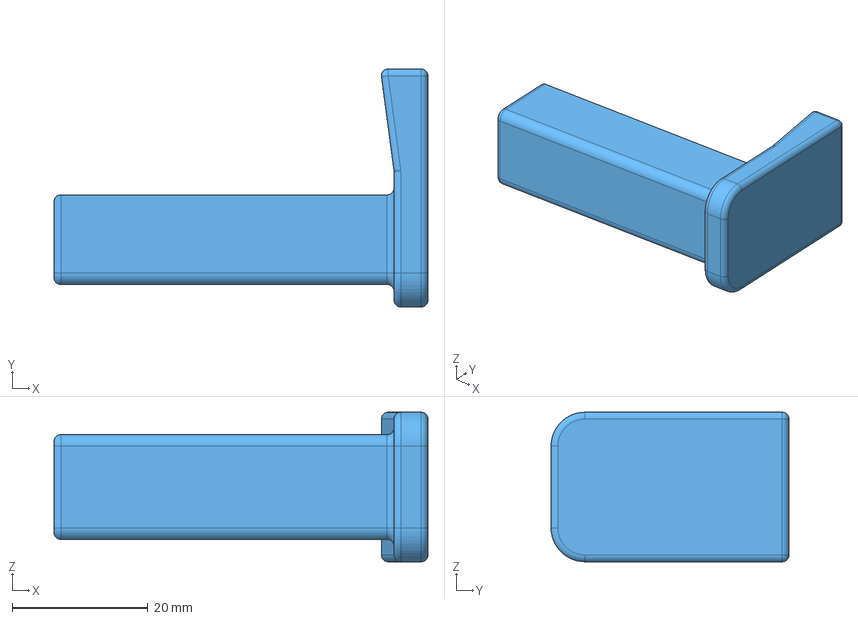
[picture p65: CAD file, 2021-07-04]
Emphy-OpenBot/OpenBot-master/body/cad/phone_mount/phone_mount_top.step
55.0 x 35.0 x 22.0 mm
