ssood123/Project-Emphy/Emphy-OpenBot/OpenBot-master/body/cad/regular_body/body_top.step

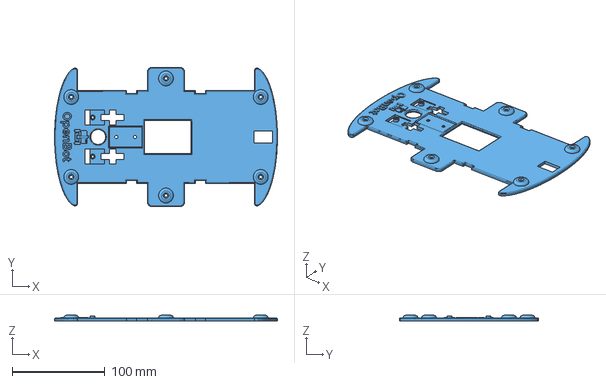
[picture p66: CAD file, 2021-07-04]
Emphy-OpenBot/OpenBot-master/body/cad/regular_body/body_top.step
240.0 x 150.0 x 6.00 mm
