ssood123/Project-Emphy/Emphy-OpenBot/OpenBot-master/body/cad/slim_body/slim_body_top_rim.step

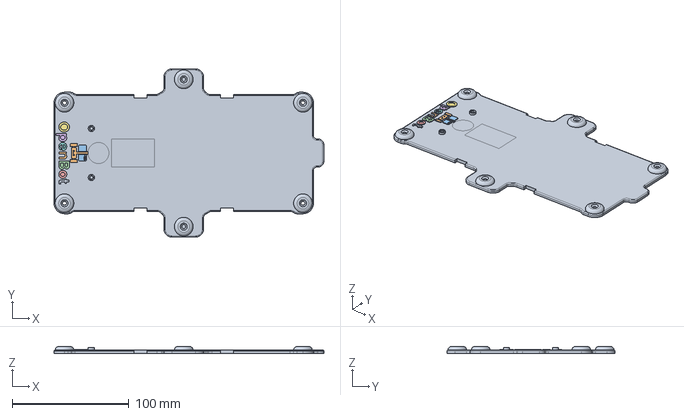
[picture p67: CAD file, 2021-07-04]
Emphy-OpenBot/OpenBot-master/body/cad/slim_body/slim_body_top_rim.step
231.0 x 144.0 x 6.00 mm
