ssood123/Project-Emphy/LeashBox/LidRight.stl

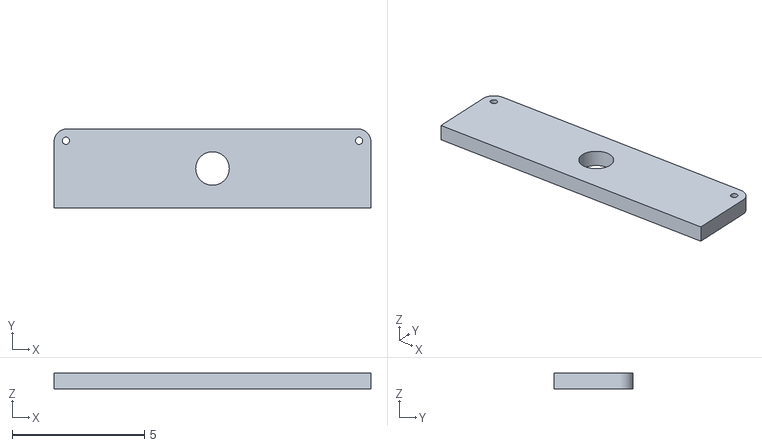
[picture p68: CAD file, 2021-07-04]
LeashBox/LidRight.stl
12.0 x 3.00 x 0.6
