ssood123/Project-Emphy/Emphy-OpenBot/OpenBot-master/body/cad/glue_body/glue_connector_bottom.step

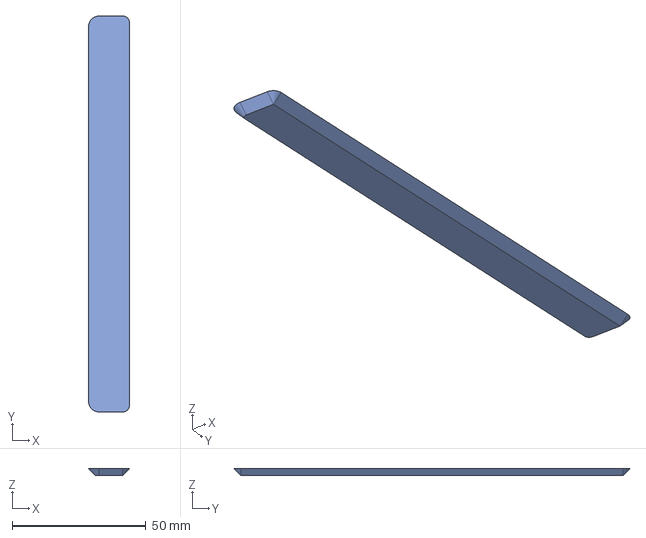
[picture p69: CAD file, 2021-07-04]
Emphy-OpenBot/OpenBot-master/body/cad/glue_body/glue_connector_bottom.step
15.3 x 148.0 x 2.54 mm
