ssood123/Project-Emphy/Emphy-OpenBot/OpenBot-master/body/cad/phone_mount/phone_mount_bottom.step

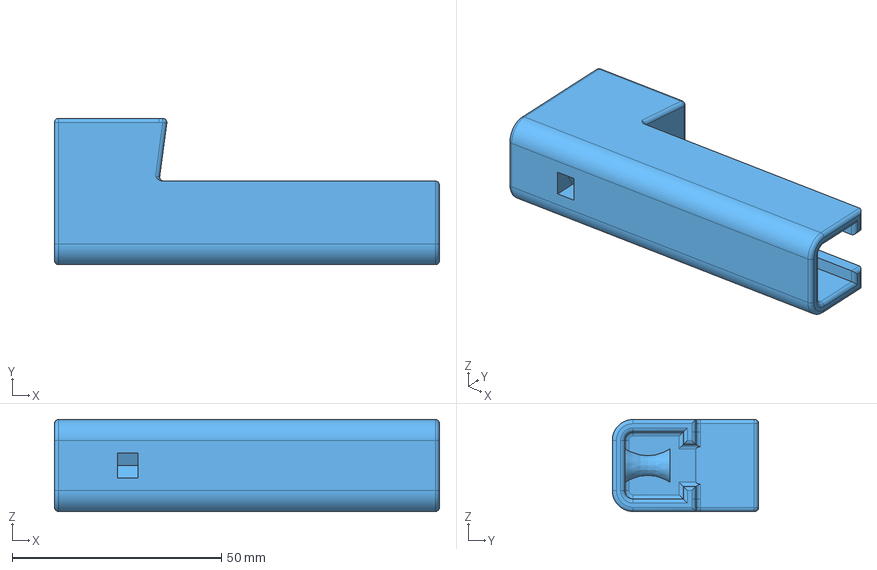
[picture p70: CAD file, 2021-07-04]
Emphy-OpenBot/OpenBot-master/body/cad/phone_mount/phone_mount_bottom.step
92.0 x 35.0 x 22.0 mm
