ssood123/Project-Emphy/Emphy-OpenBot/OpenBot-master/body/cad/regular_body/body_bottom.step

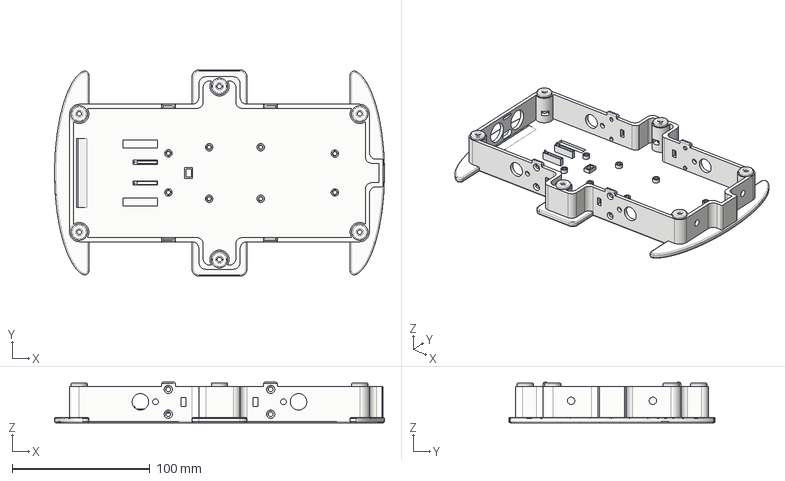
[picture p71: CAD file, 2021-07-04]
Emphy-OpenBot/OpenBot-master/body/cad/regular_body/body_bottom.step
240.0 x 150.0 x 29.5 mm
