ssood123/Project-Emphy/Emphy-OpenBot/OpenBot-master/body/cad/slim_body/slim_body_top.step

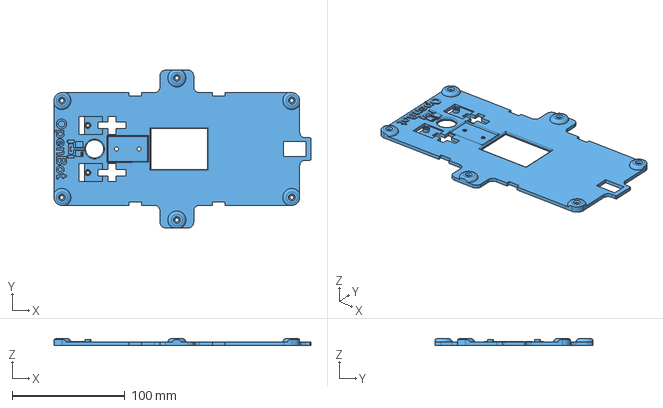
[picture p72: CAD file, 2021-07-04]
Emphy-OpenBot/OpenBot-master/body/cad/slim_body/slim_body_top.step
228.0 x 140.0 x 6.00 mm
