ssood123/Project-Emphy/LeashBox/Box.stl

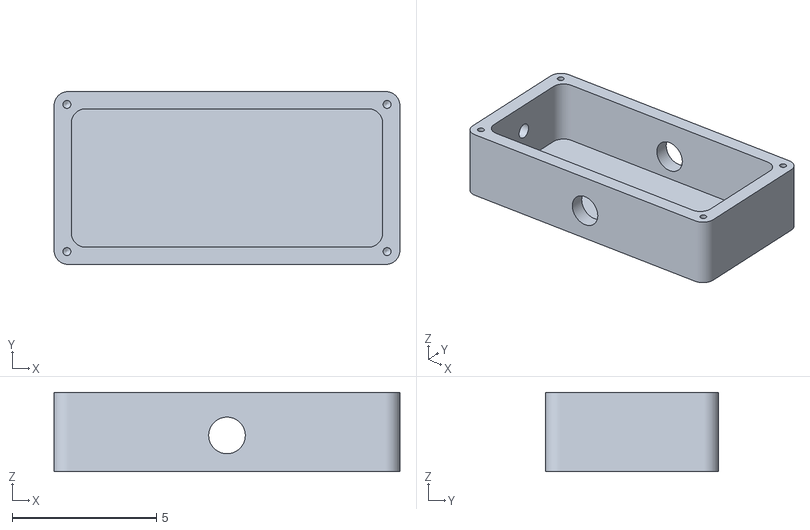
[picture p73: CAD file, 2021-07-04]
LeashBox/Box.stl
12.0 x 6.00 x 2.75
