ssood123/Project-Emphy/Emphy-OpenBot/OpenBot-master/body/cad/glue_body/glue_body_top_A.step

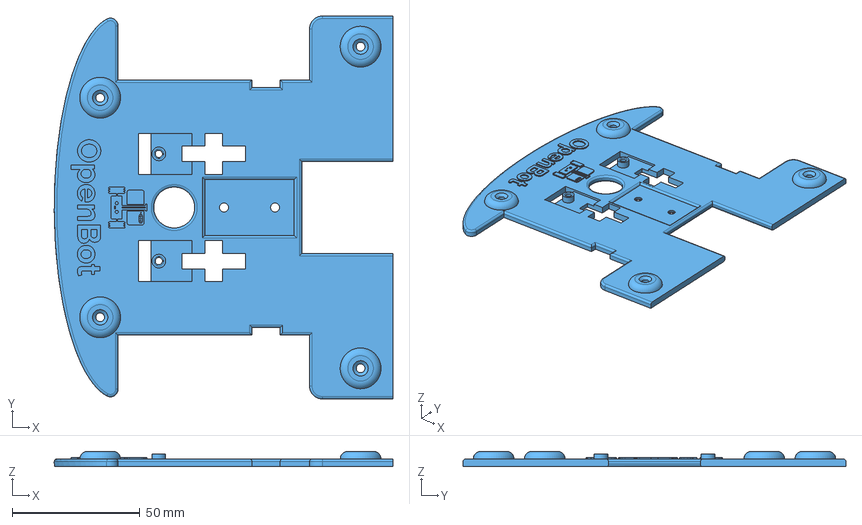
[picture p74: CAD file, 2021-07-04]
Emphy-OpenBot/OpenBot-master/body/cad/glue_body/glue_body_top_A.step
132.6 x 150.0 x 6.00 mm
