ssood123/Project-Emphy/Emphy-OpenBot/OpenBot-master/body/cad/slim_body/slim_body_bottom.step

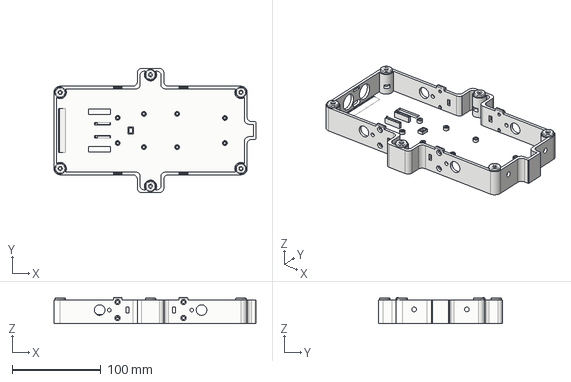
[picture p75: CAD file, 2021-07-04]
Emphy-OpenBot/OpenBot-master/body/cad/slim_body/slim_body_bottom.step
228.0 x 140.0 x 29.5 mm
