ssood123/Project-Emphy/Emphy-OpenBot/OpenBot-master/body/cad/glue_body/glue_body_bottom_A.step

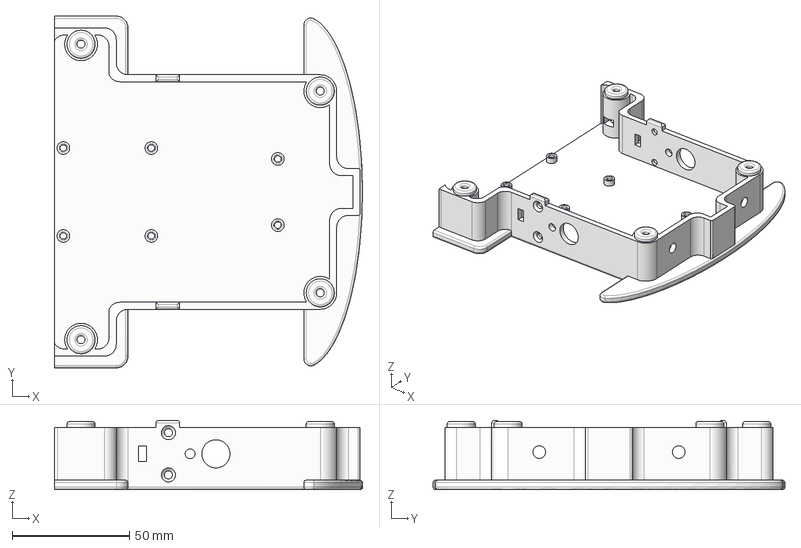
[picture p76: CAD file, 2021-07-04]
Emphy-OpenBot/OpenBot-master/body/cad/glue_body/glue_body_bottom_A.step
131.3 x 150.0 x 29.5 mm
