ssood123/Project-Emphy/Emphy-OpenBot/OpenBot-master/body/cad/glue_body/glue_body_bottom_B.step

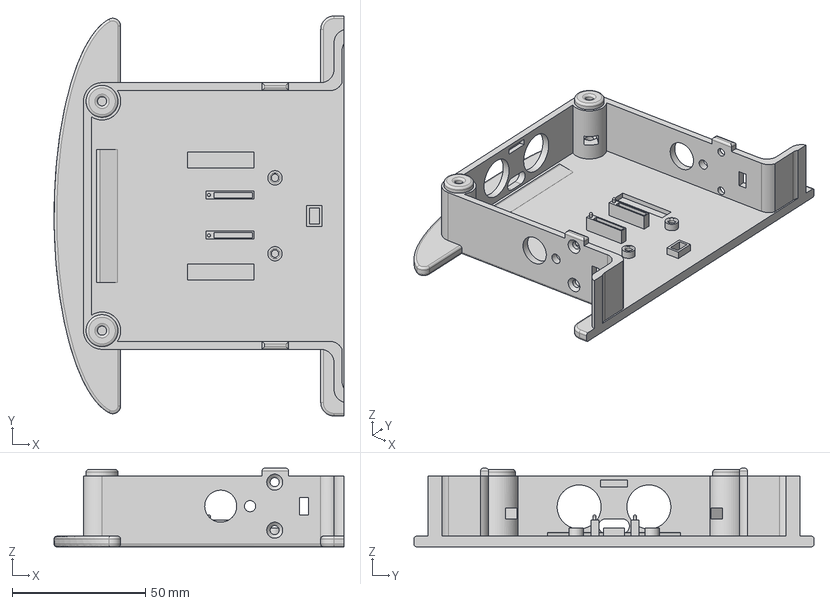
[picture p77: CAD file, 2021-07-04]
Emphy-OpenBot/OpenBot-master/body/cad/glue_body/glue_body_bottom_B.step
108.6 x 150.0 x 29.5 mm
