ssood123/Project-Emphy/Emphy-OpenBot/OpenBot-master/body/cad/glue_body/glue_body_top_B.step

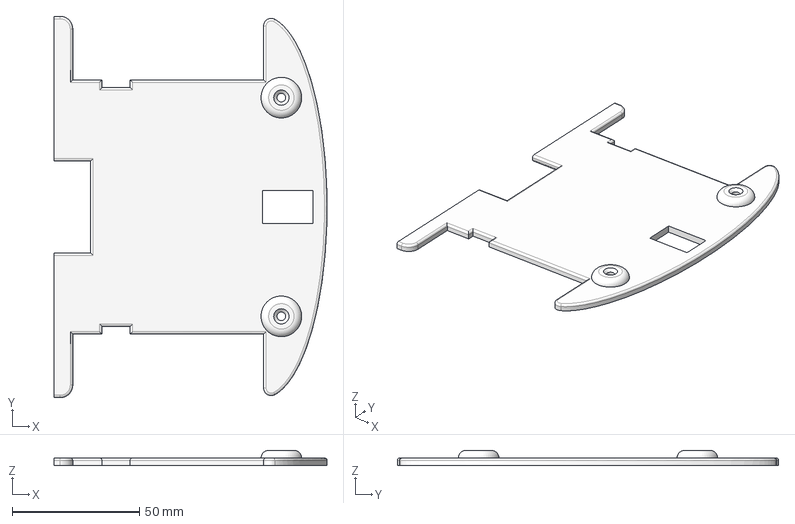
[picture p78: CAD file, 2021-07-04]
Emphy-OpenBot/OpenBot-master/body/cad/glue_body/glue_body_top_B.step
107.3 x 150.0 x 6.00 mm
