ssood123/Project-Emphy/(list of files, cad)

Other CAD files:
Emphy-OpenBot/OpenBot-master/body/cad/glue_body/glue_connector_top_B.step
Emphy-OpenBot/OpenBot-master/body/cad/glue_body/glue_body_bottom_A.stl
Emphy-OpenBot/OpenBot-master/body/cad/glue_body/glue_body_bottom_B.stl
Emphy-OpenBot/OpenBot-master/body/cad/glue_body/glue_body_top_A.stl
Emphy-OpenBot/OpenBot-master/body/cad/glue_body/glue_body_top_B.stl
Emphy-OpenBot/OpenBot-master/body/cad/glue_body/glue_connector_bottom.stl
Emphy-OpenBot/OpenBot-master/body/cad/glue_body/glue_connector_top_A.stl
Emphy-OpenBot/OpenBot-master/body/cad/glue_body/glue_connector_top_B.stl
Emphy-OpenBot/OpenBot-master/body/cad/phone_mount/phone_mount_bottom.stl
Emphy-OpenBot/OpenBot-master/body/cad/phone_mount/phone_mount_top.stl
Emphy-OpenBot/OpenBot-master/body/cad/regular_body/body_bottom.stl
Emphy-OpenBot/OpenBot-master/body/cad/regular_body/body_top.stl
Emphy-OpenBot/OpenBot-master/body/cad/slim_body/slim_body_bottom.stl
Emphy-OpenBot/OpenBot-master/body/cad/slim_body/slim_body_top.stl
Emphy-OpenBot/OpenBot-master/body/cad/slim_body/slim_body_top_rim.stl
