ssood123/Project-Emphy/Emphy-OpenBot/OpenBot-master/docs/images/assembly_service.jpg

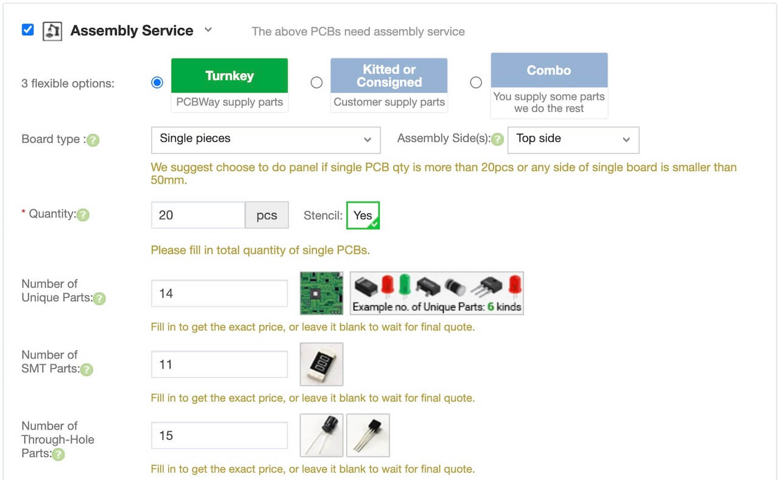
Emphy-OpenBot/OpenBot-master/docs/images/assembly_service.jpg
