ssood123/Project-Emphy/Emphy-OpenBot/OpenBot-master/docs/images/clean_3d_print_1.jpg

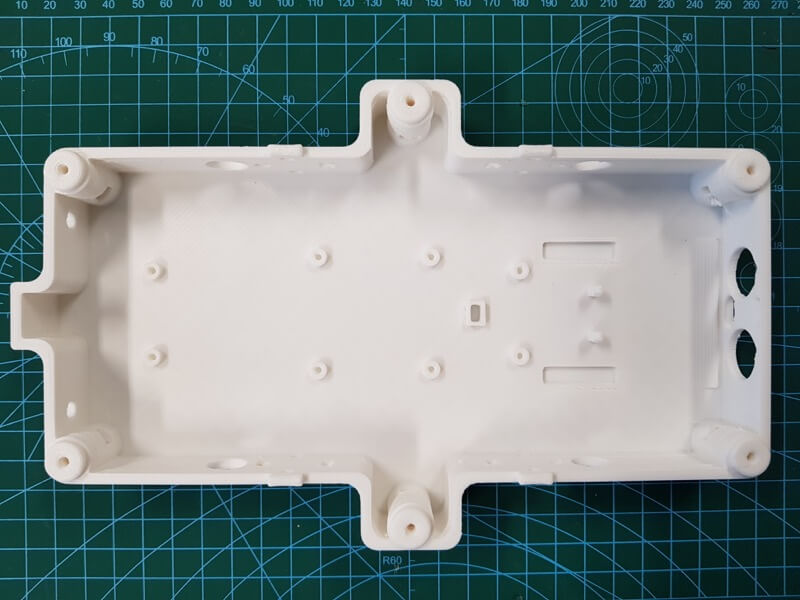
Emphy-OpenBot/OpenBot-master/docs/images/clean_3d_print_1.jpg
