ssood123/Project-Emphy/Emphy-OpenBot/OpenBot-master/docs/images/install_library.jpg

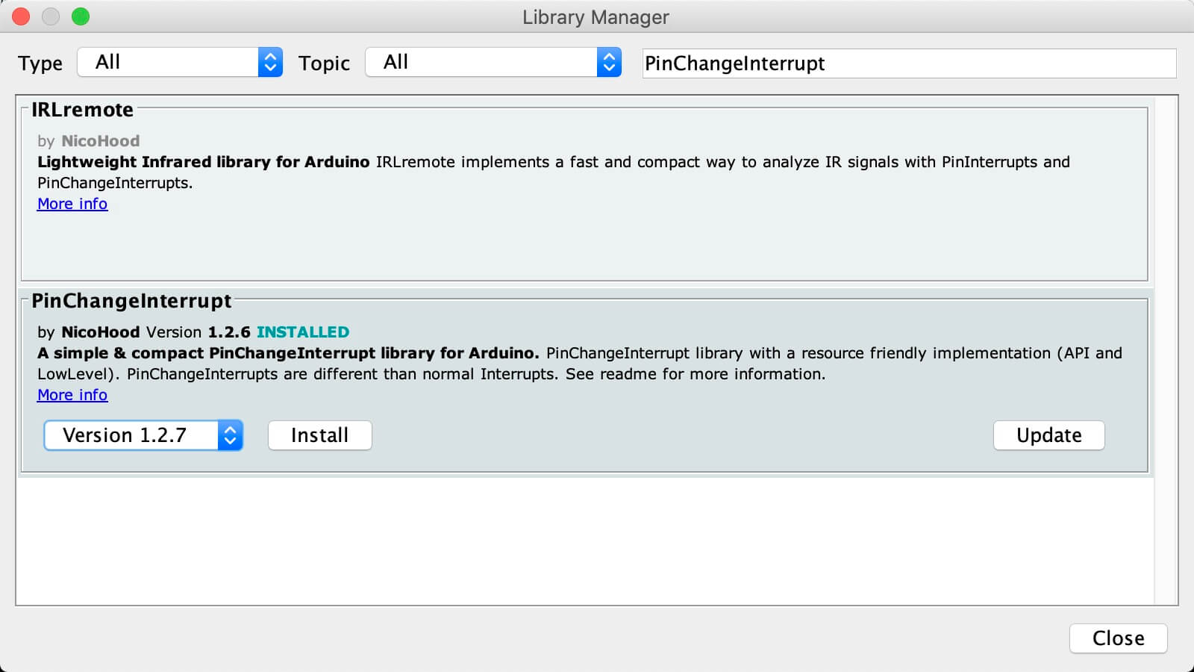
Emphy-OpenBot/OpenBot-master/docs/images/install_library.jpg
