ssood123/Project-Emphy/Emphy-OpenBot/OpenBot-master/docs/images/install_speed_sensor_1.jpg

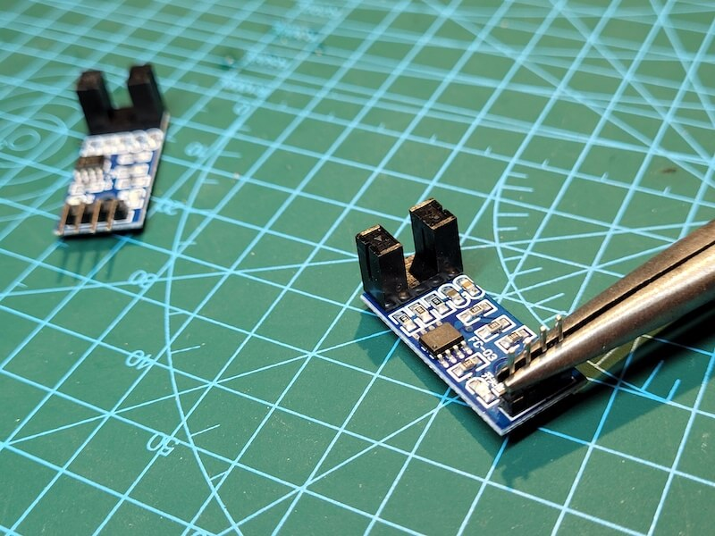
Emphy-OpenBot/OpenBot-master/docs/images/install_speed_sensor_1.jpg
