ssood123/Project-Emphy/Emphy-OpenBot/OpenBot-master/docs/images/install_speed_sensor_2.jpg

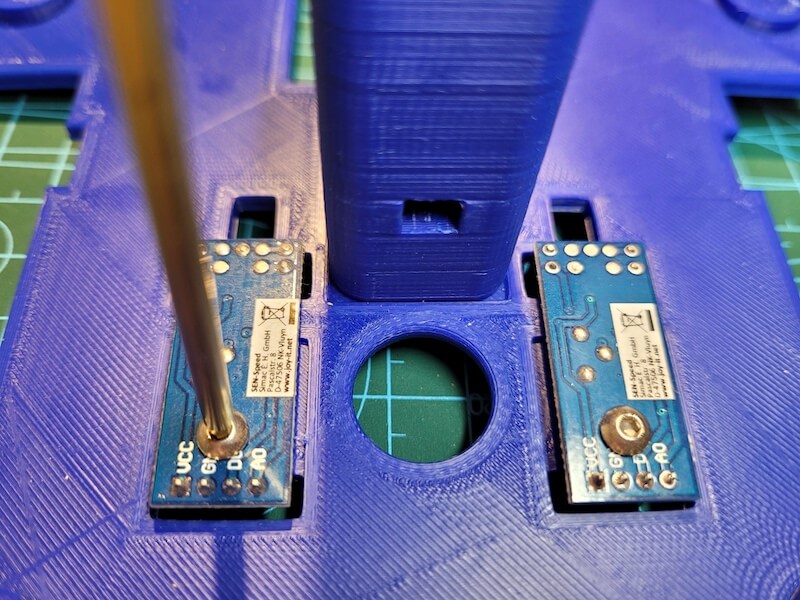
Emphy-OpenBot/OpenBot-master/docs/images/install_speed_sensor_2.jpg
