ssood123/Project-Emphy/Emphy-OpenBot/OpenBot-master/docs/images/install_spring_2.jpg

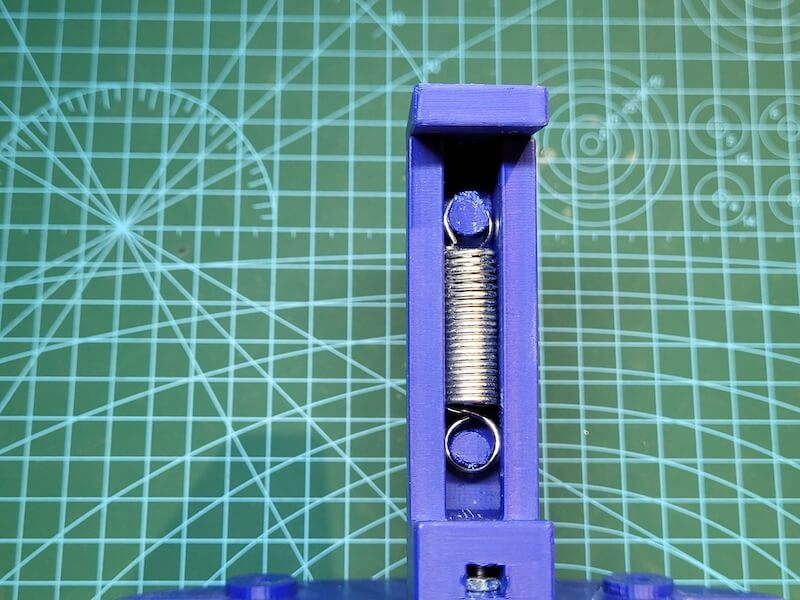
Emphy-OpenBot/OpenBot-master/docs/images/install_spring_2.jpg
