ssood123/Project-Emphy/Emphy-OpenBot/OpenBot-master/docs/images/install_switch_1.jpg

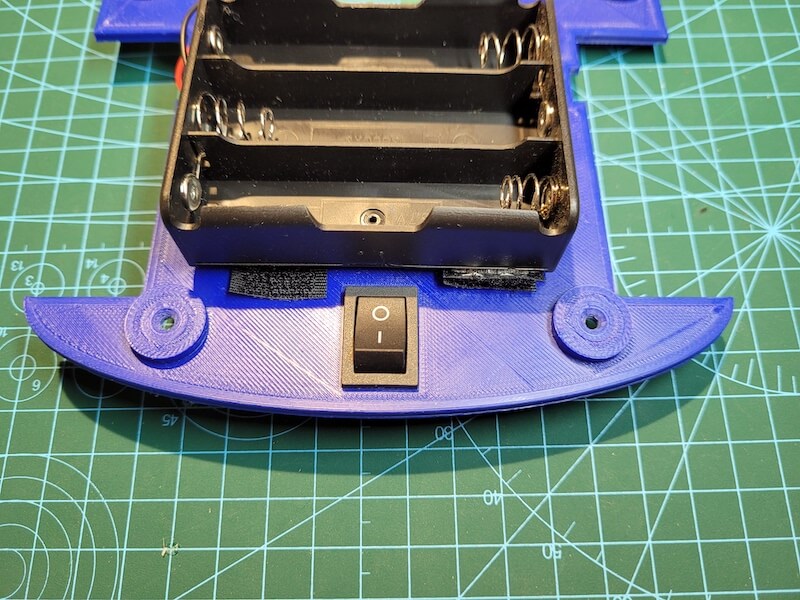
Emphy-OpenBot/OpenBot-master/docs/images/install_switch_1.jpg
