ssood123/Project-Emphy/Emphy-OpenBot/OpenBot-master/docs/images/install_switch_3.jpg

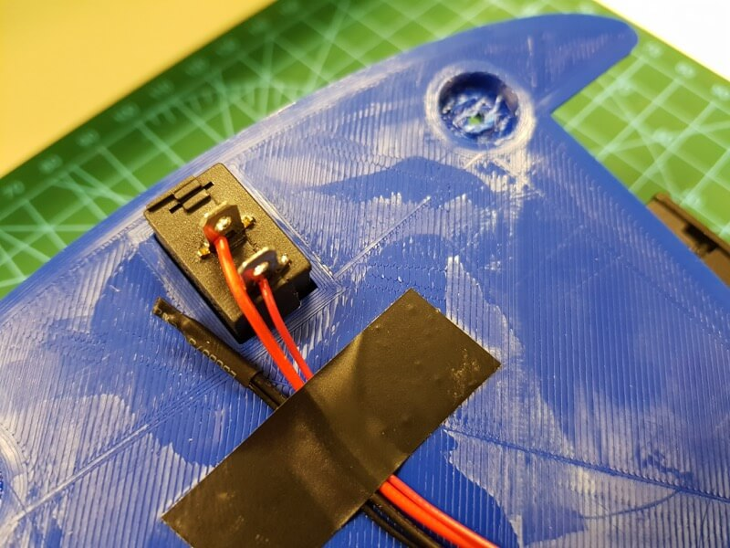
Emphy-OpenBot/OpenBot-master/docs/images/install_switch_3.jpg
